Pythorian/Conversor-Buck-Didatico/README.md

# Conversor-Buck-Didatico
 Este trabalho é um conversor Buck desenvolvido para ajudar nas aulas de Eletrônica de Potência e Controle Digital.
