Pythorian/Conversor-Buck-Didatico/Referências/engenharia/IRF530.pdf

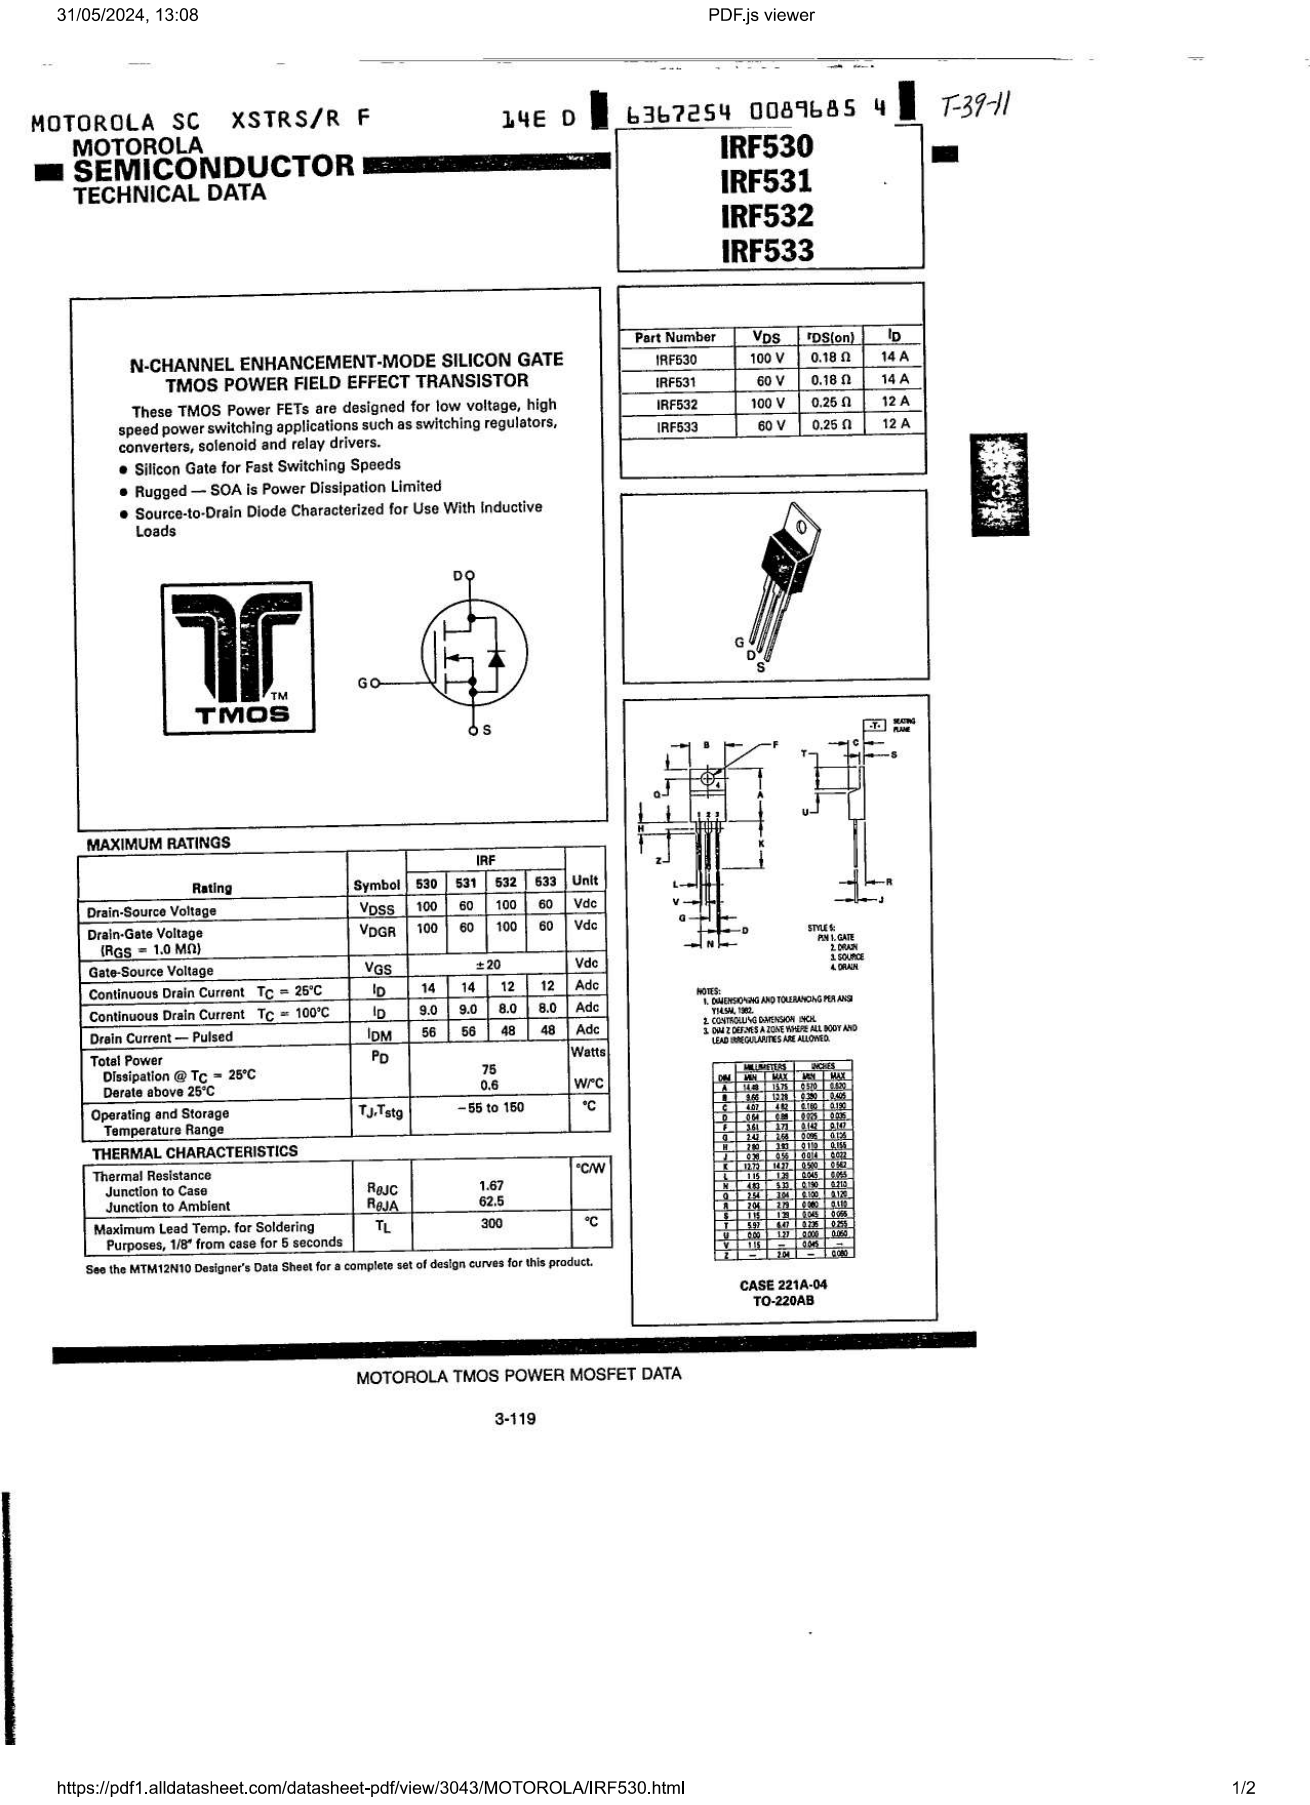
[picture p16: page 1]

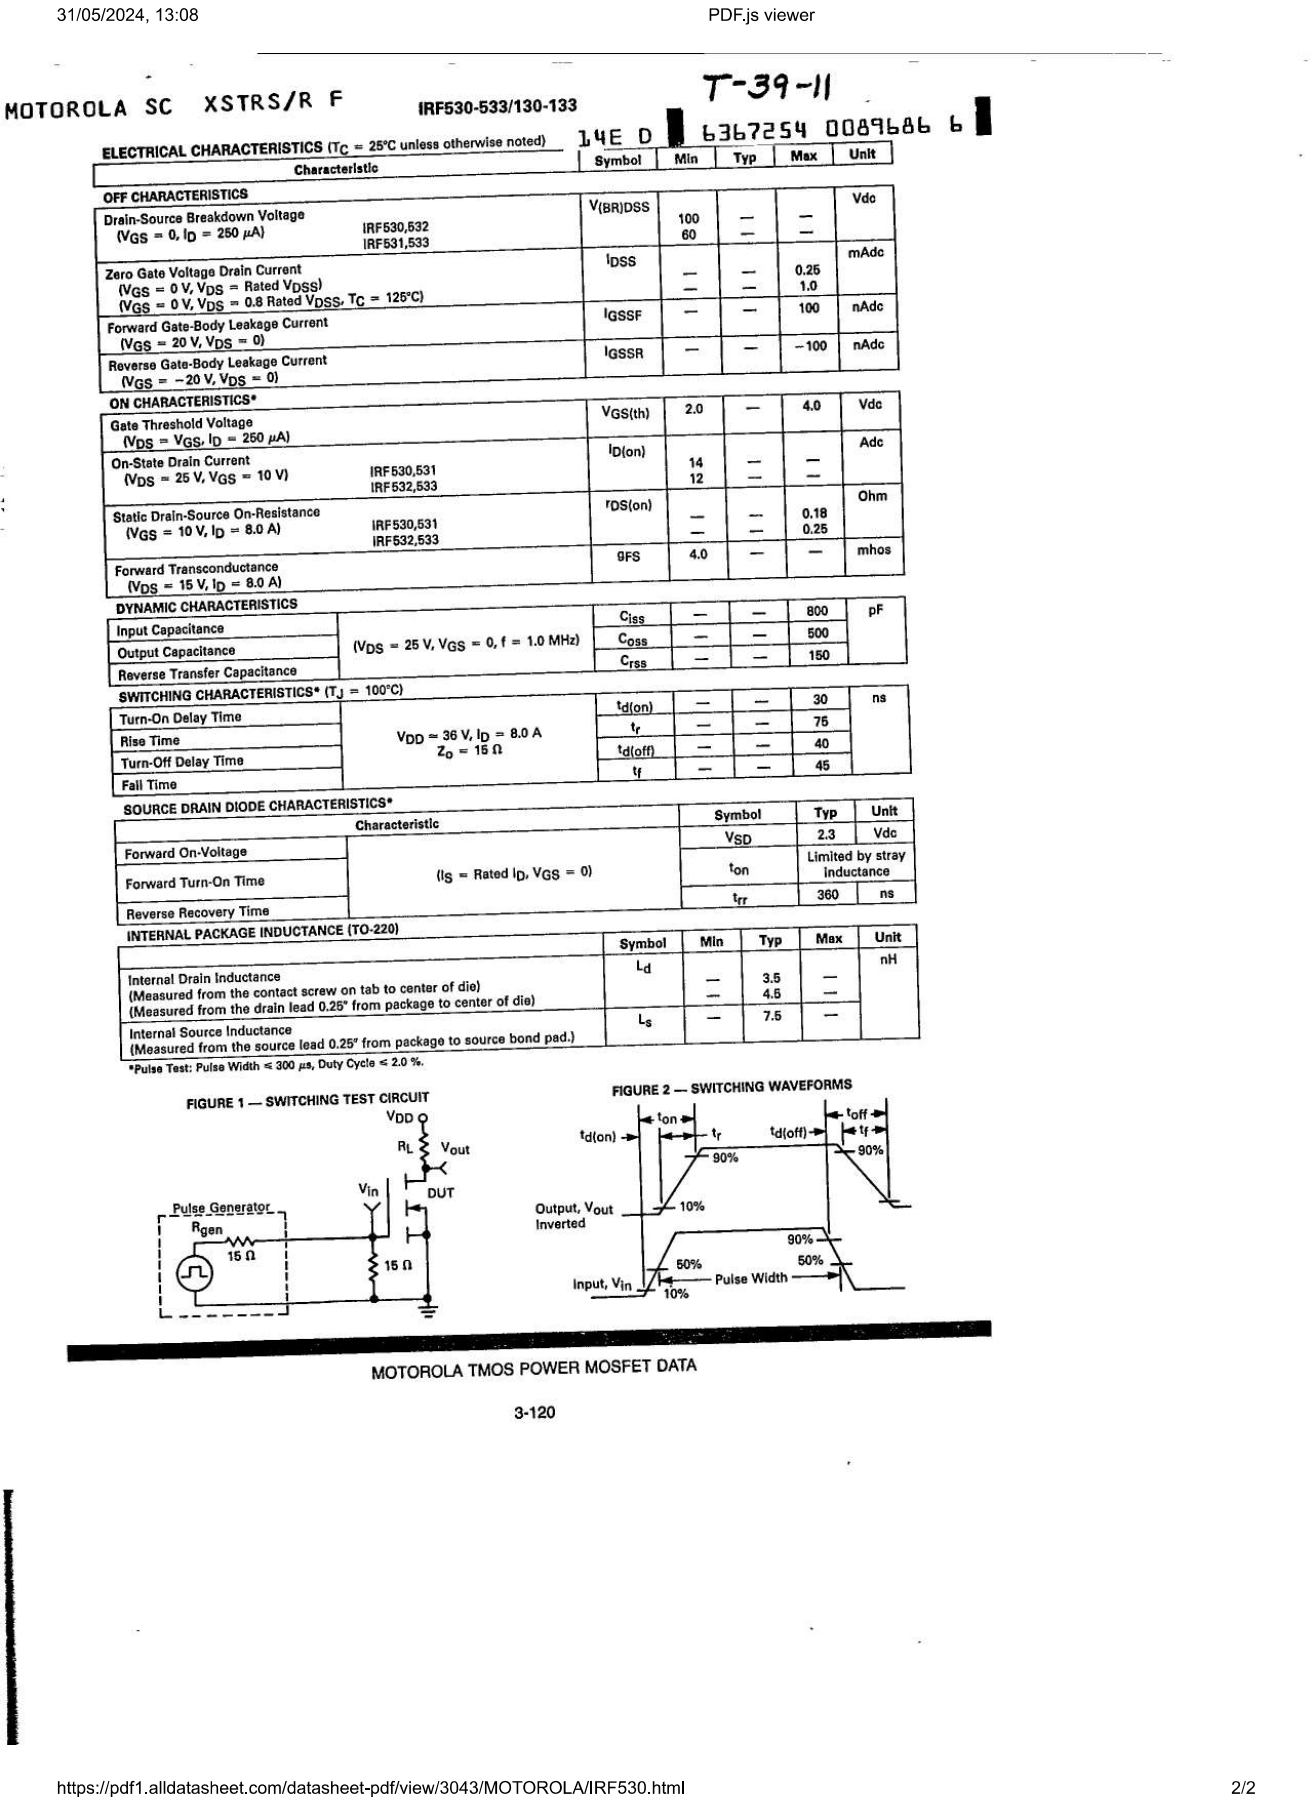
[picture p17: page 2]
