Pythorian/Conversor-Buck-Didatico/Referências/engenharia/LA25NP.pdf

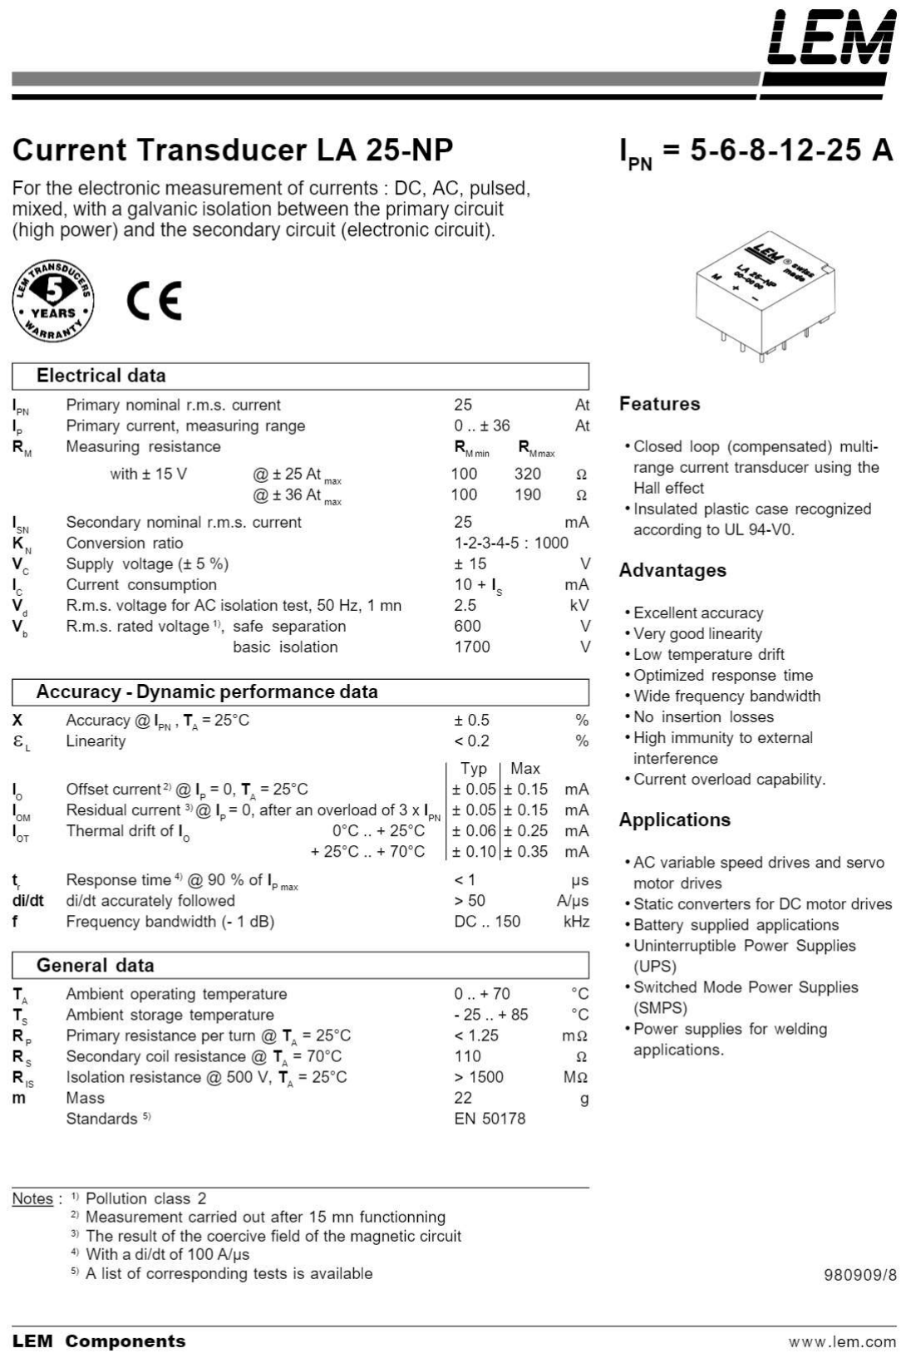
[picture p18: page 1]
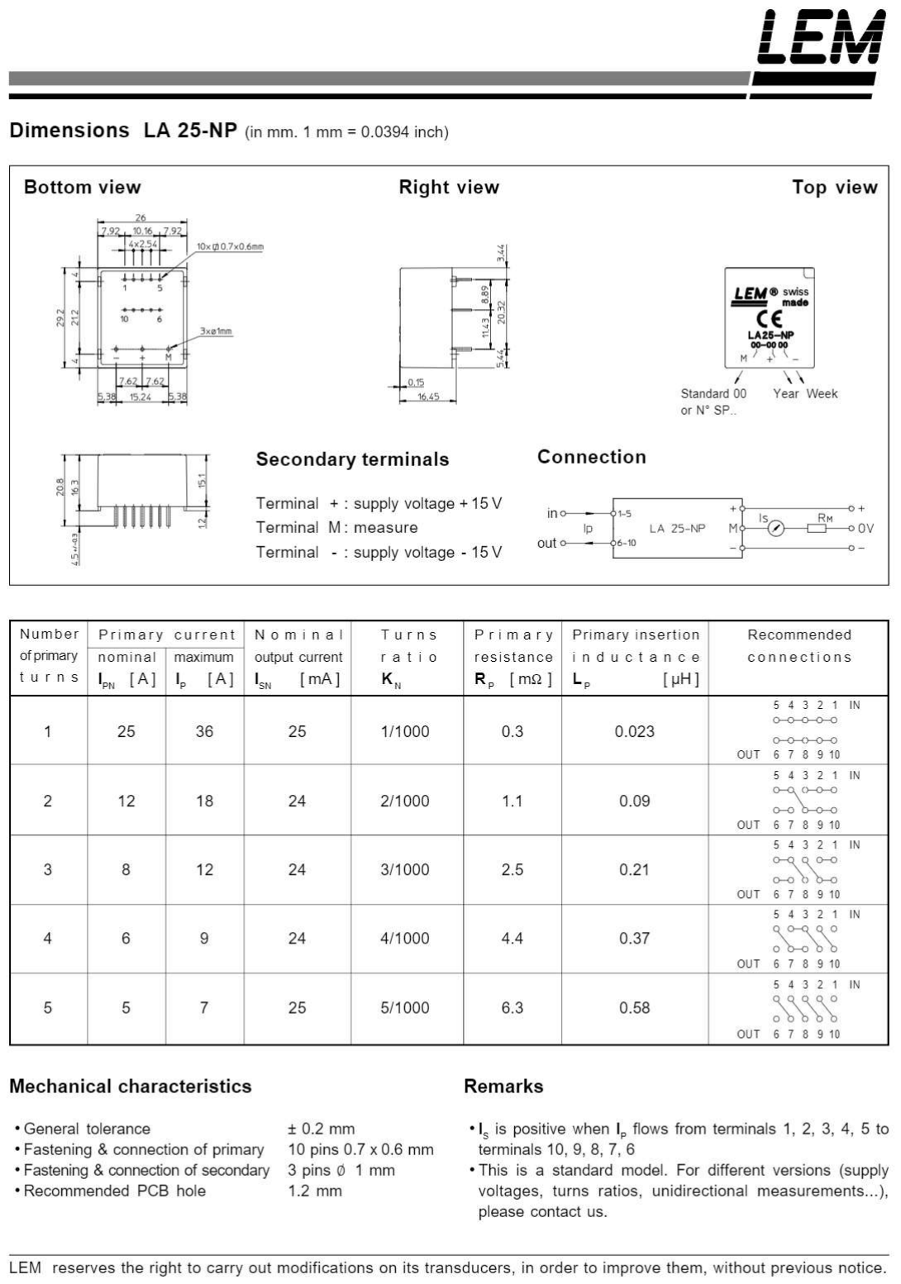
[picture p19: page 2]
