Pythorian/Conversor-Buck-Didatico/Imagens/Produzidas pelo autor/bucketapa1.png

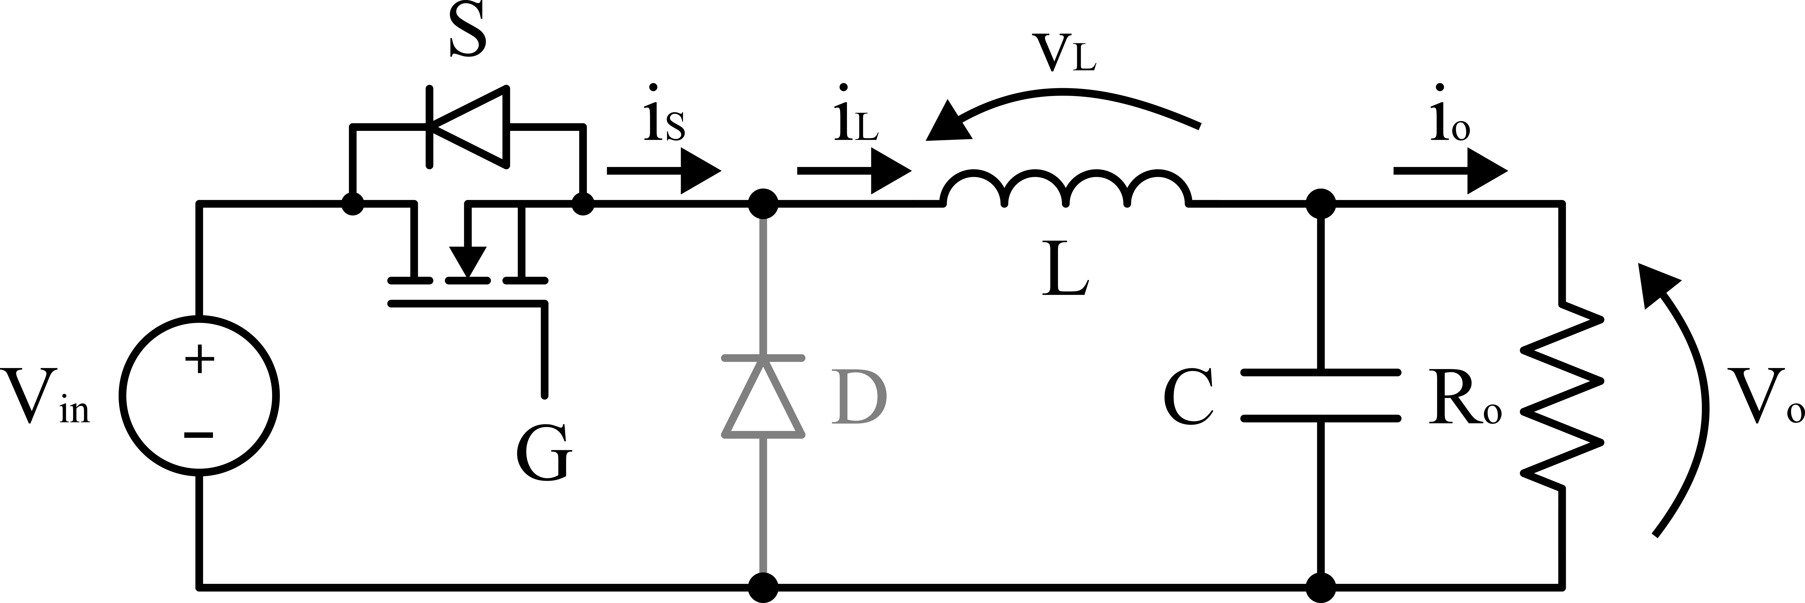
Imagens/Produzidas pelo autor/bucketapa1.png
