Pythorian/Conversor-Buck-Didatico/Imagens/Produzidas pelo autor/bucketapa1medidas.png

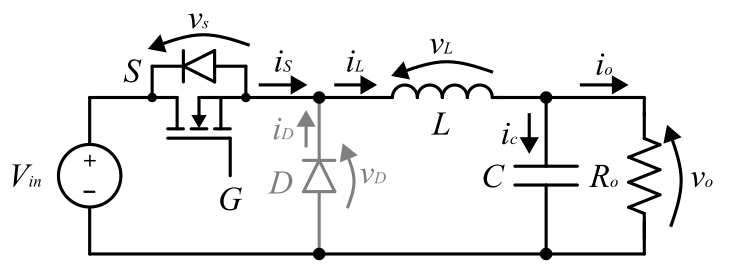
Imagens/Produzidas pelo autor/bucketapa1medidas.png
