Pythorian/Conversor-Buck-Didatico/Imagens/Produzidas pelo autor/bucketapa2.png

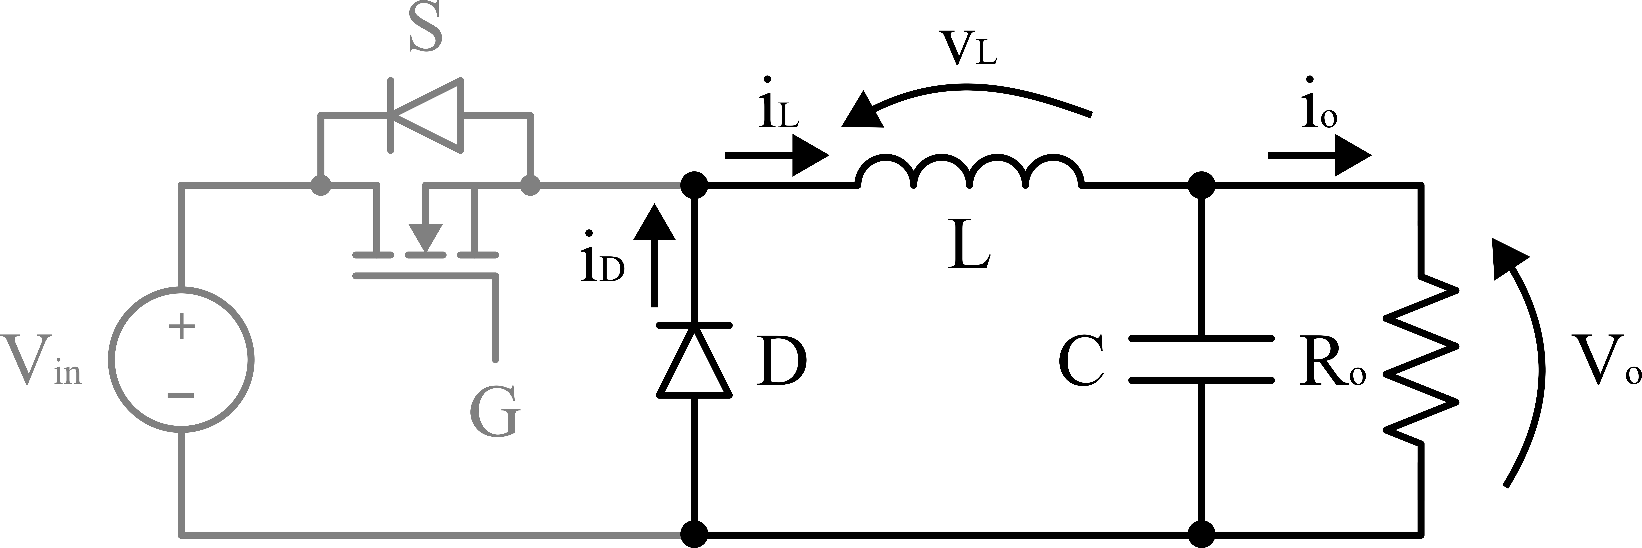
Imagens/Produzidas pelo autor/bucketapa2.png
