Pythorian/Conversor-Buck-Didatico/Imagens/Produzidas pelo autor/bucketapa2medidas.png

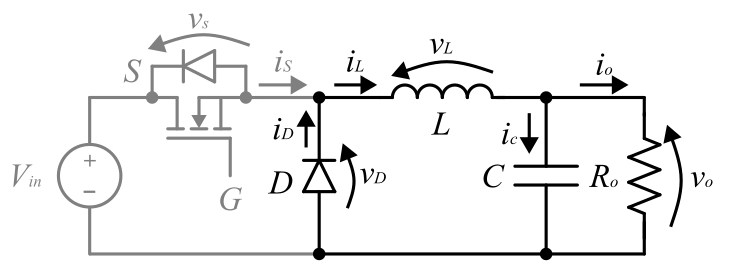
Imagens/Produzidas pelo autor/bucketapa2medidas.png
