Pythorian/Conversor-Buck-Didatico/Imagens/Produzidas pelo autor/buckgraficos.png

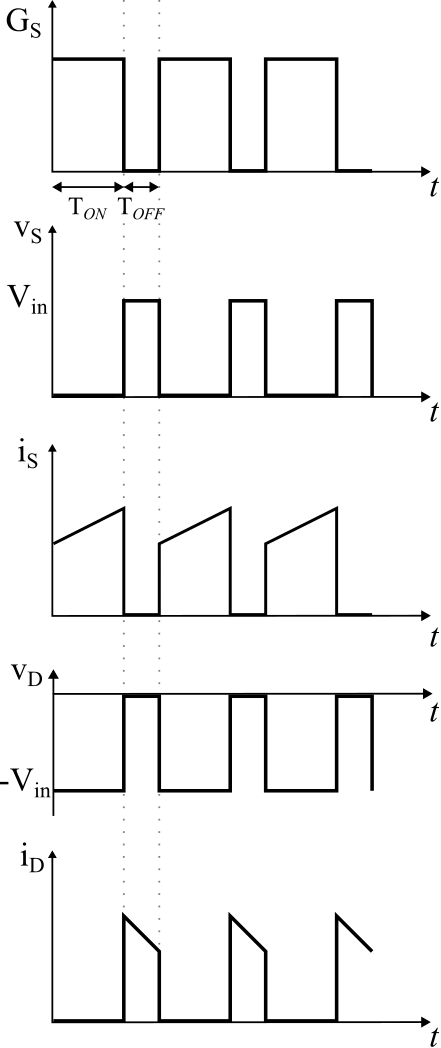
Imagens/Produzidas pelo autor/buckgraficos.png
