Pythorian/Conversor-Buck-Didatico/Imagens/Produzidas pelo autor/buckmalhatensao.png

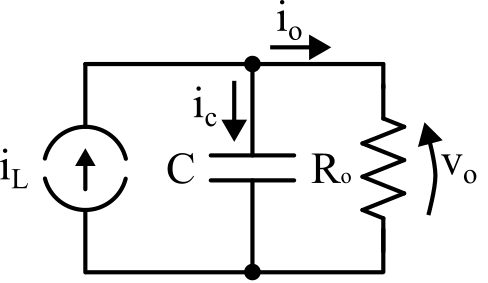
Imagens/Produzidas pelo autor/buckmalhatensao.png
