Pythorian/Conversor-Buck-Didatico/Imagens/Produzidas pelo autor/buckmedidas.png

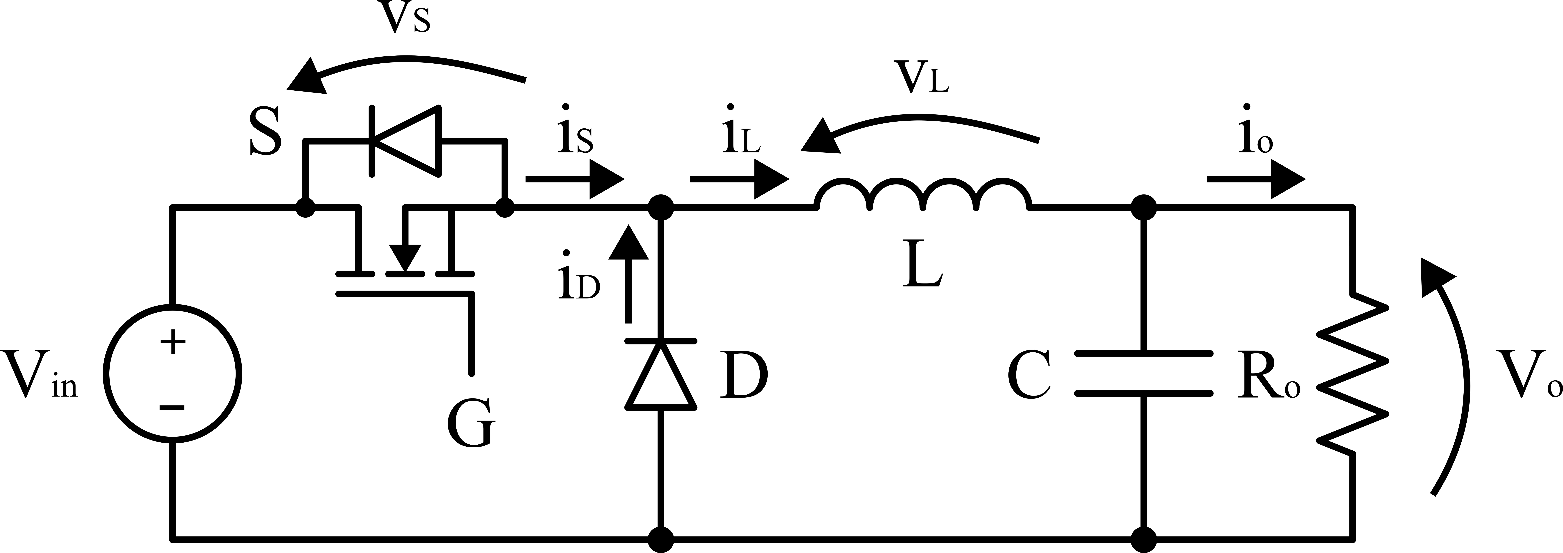
Imagens/Produzidas pelo autor/buckmedidas.png
