Pythorian/Conversor-Buck-Didatico/Imagens/Produzidas pelo autor/bucksolo.png

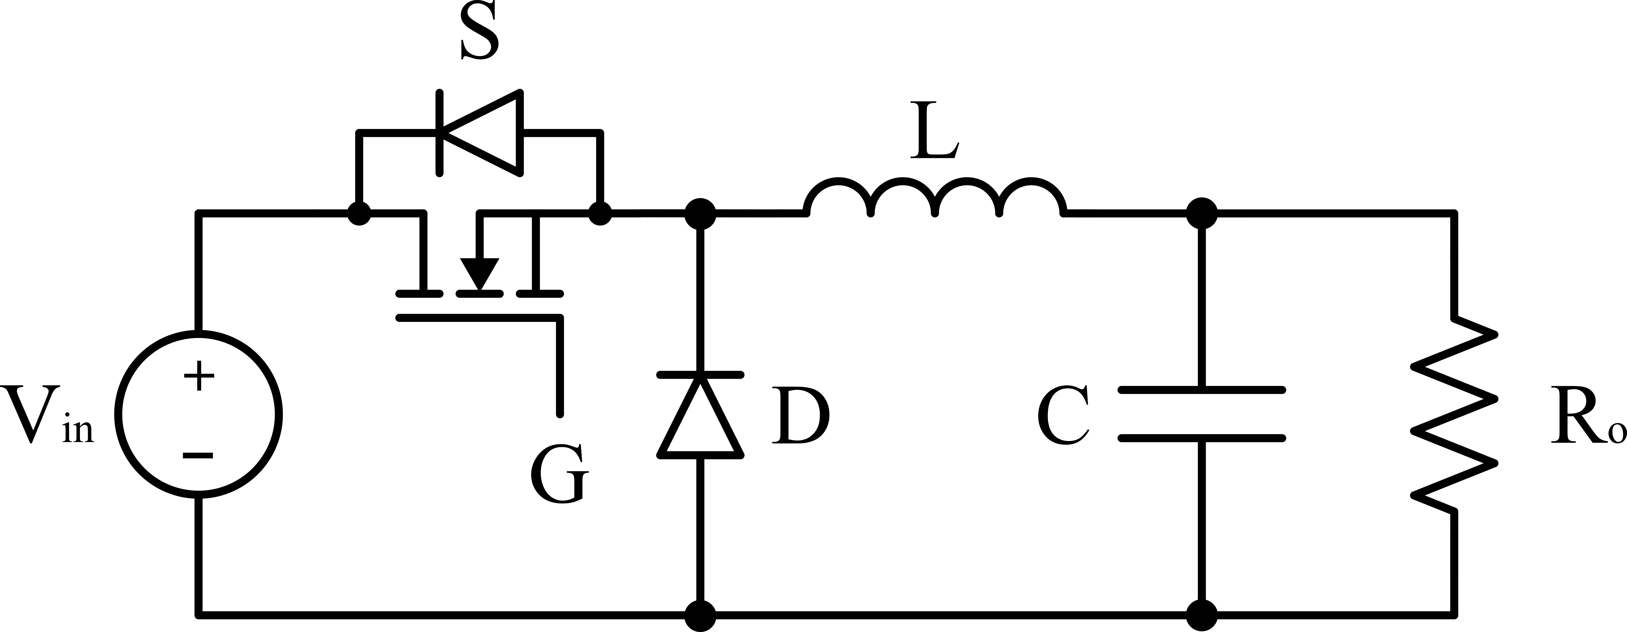
Imagens/Produzidas pelo autor/bucksolo.png
