Pythorian/Conversor-Buck-Didatico/Imagens/Produzidas pelo autor/formasdeondacapacitor.png

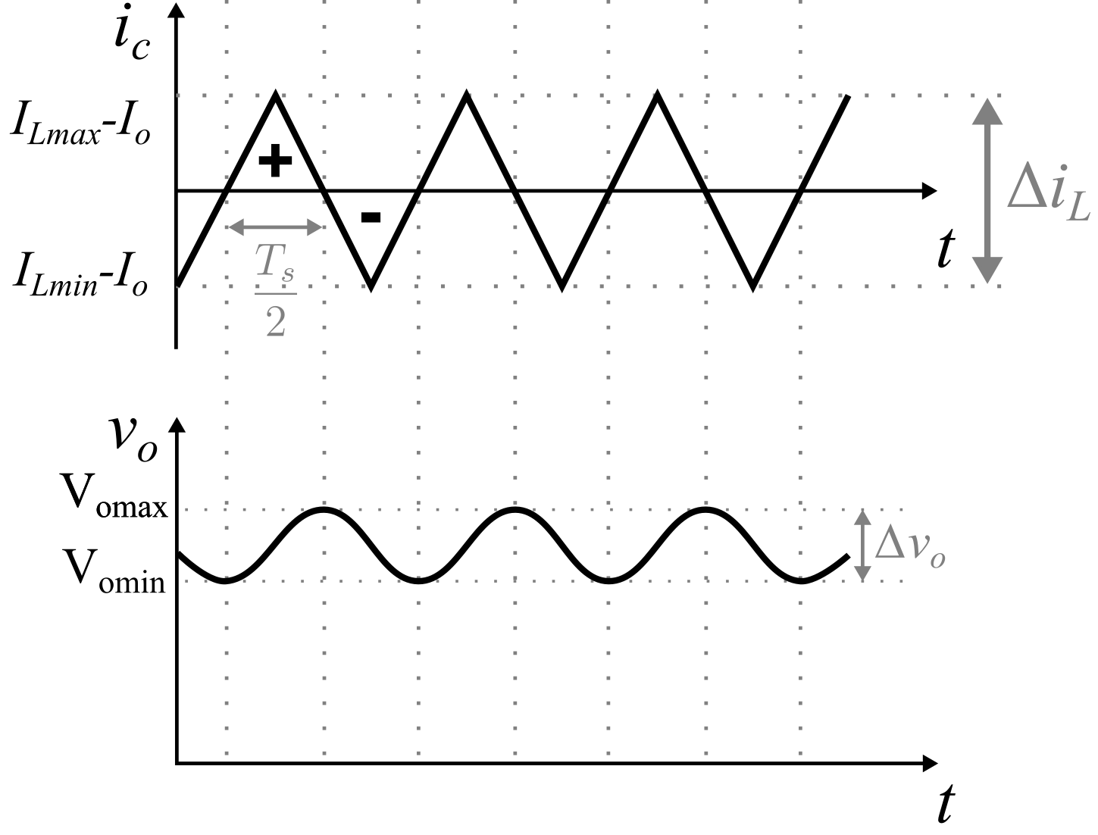
Imagens/Produzidas pelo autor/formasdeondacapacitor.png
