Pythorian/Conversor-Buck-Didatico/Imagens/Produzidas pelo autor/formasdeondaindutor.png

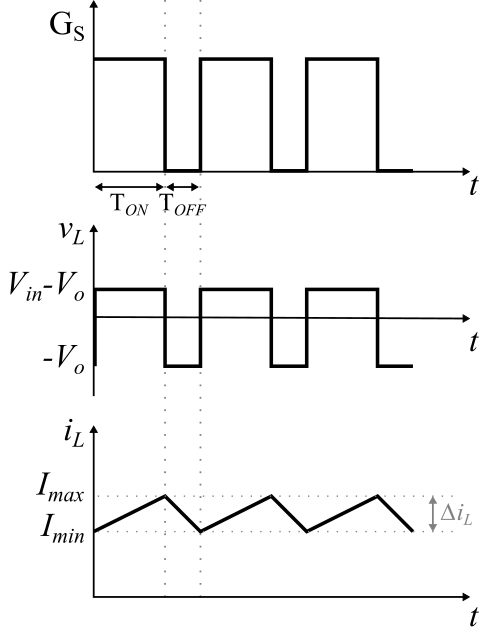
Imagens/Produzidas pelo autor/formasdeondaindutor.png
