Pythorian/Conversor-Buck-Didatico/Imagens/Produzidas pelo autor/malhascontrole.png

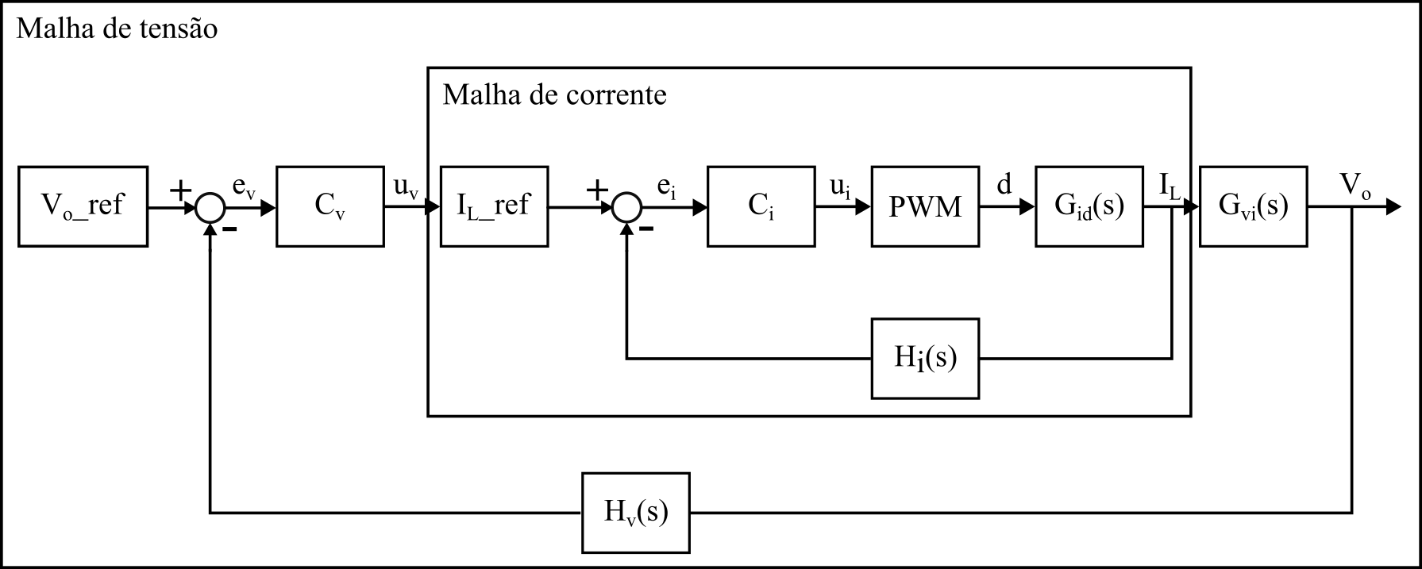
Imagens/Produzidas pelo autor/malhascontrole.png
