Pythorian/Conversor-Buck-Didatico/Imagens/Produzidas pelo autor/psimcontrolegraficos1.png

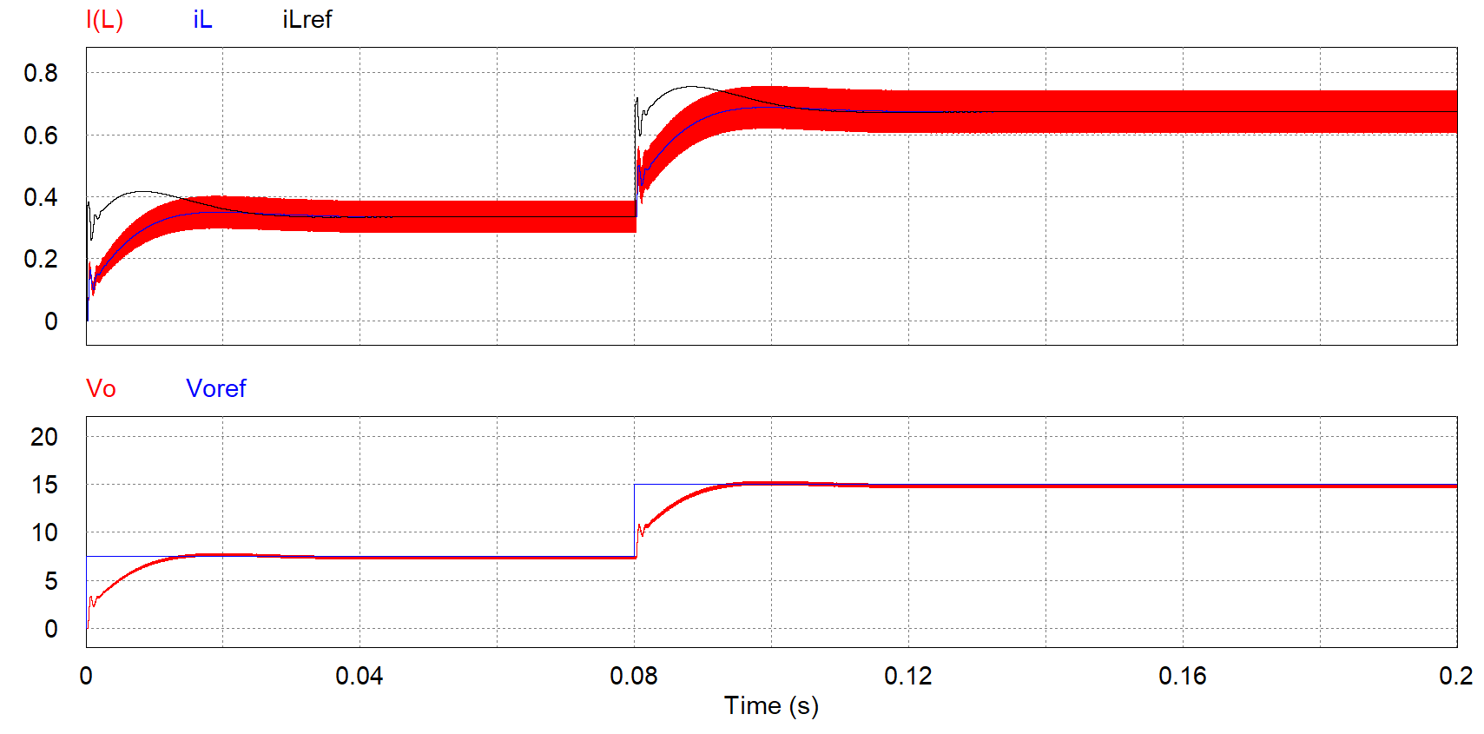
Imagens/Produzidas pelo autor/psimcontrolegraficos1.png
