Pythorian/Conversor-Buck-Didatico/Imagens/Produzidas pelo autor/psimcontrolegraficos2.png

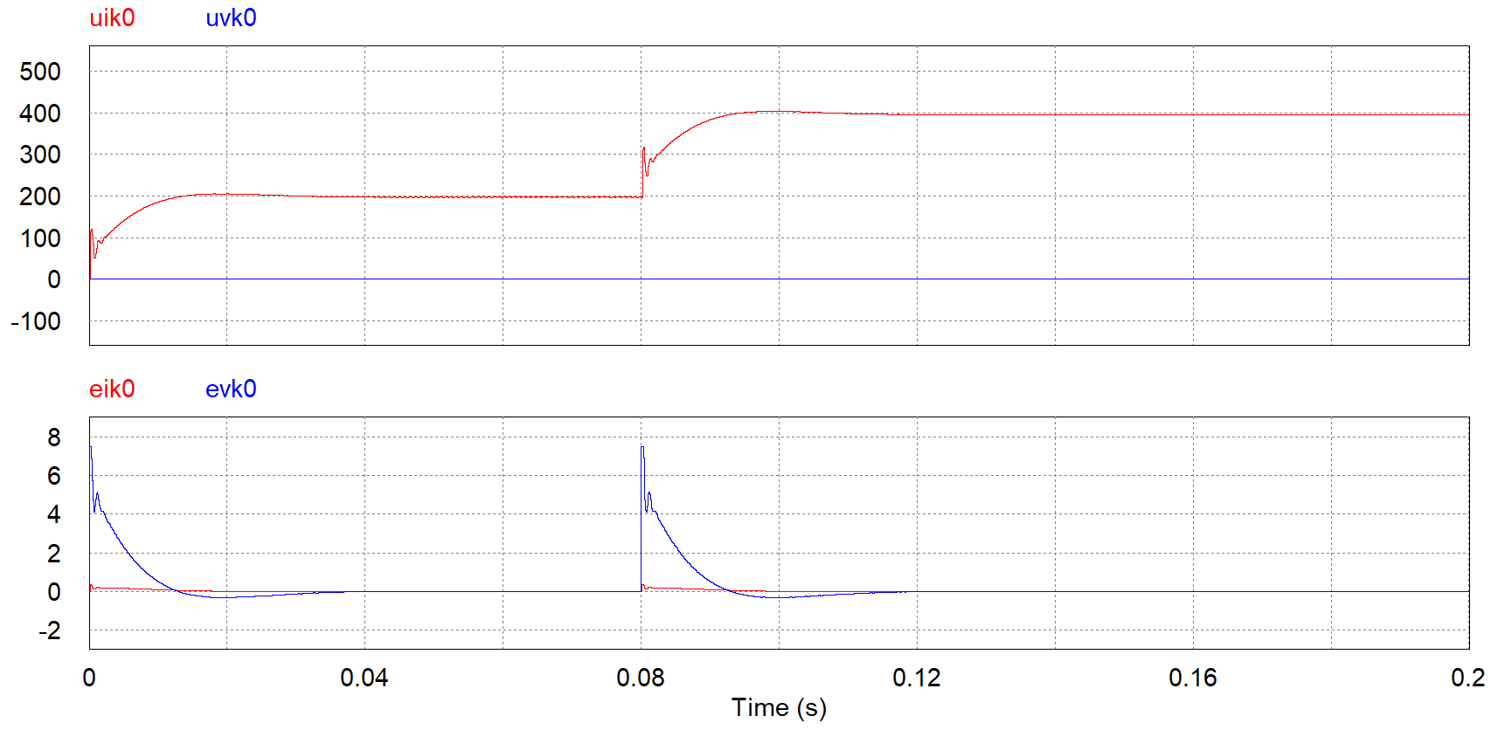
Imagens/Produzidas pelo autor/psimcontrolegraficos2.png
