Pythorian/Conversor-Buck-Didatico/Imagens/Produzidas pelo autor/psimvalidacaocorrente.png

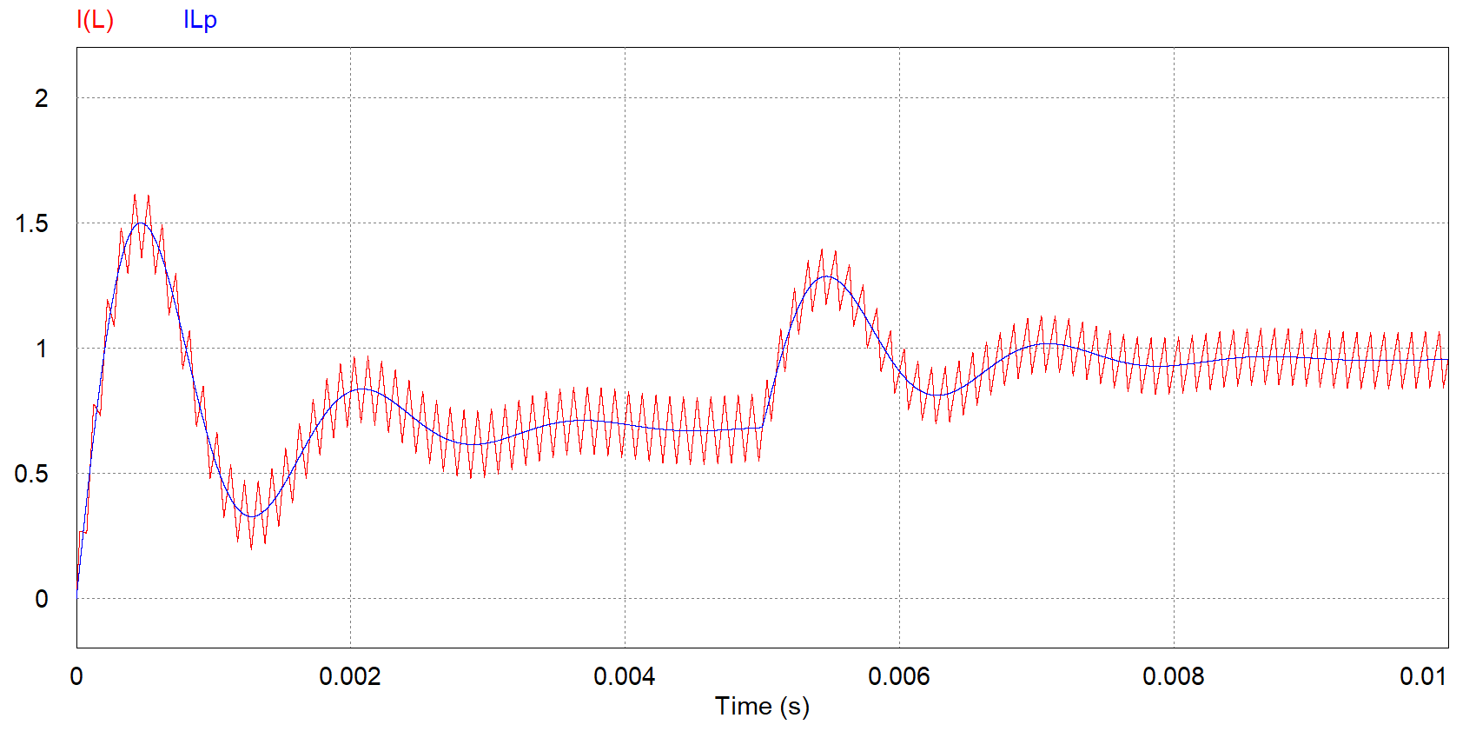
Imagens/Produzidas pelo autor/psimvalidacaocorrente.png
