Pythorian/Conversor-Buck-Didatico/Imagens/Produzidas pelo autor/psimvalidacaotensao.png

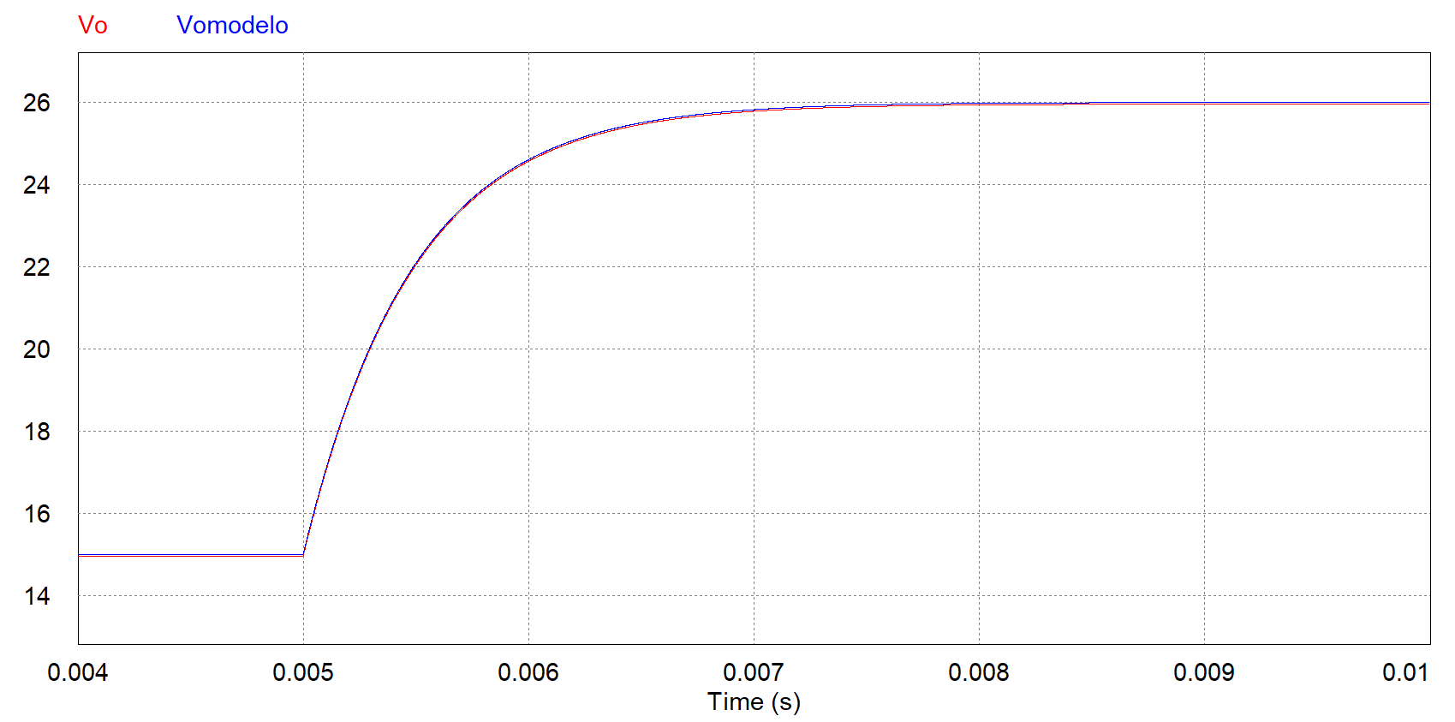
Imagens/Produzidas pelo autor/psimvalidacaotensao.png
