Pythorian/Conversor-Buck-Didatico/Imagens/Produzidas pelo autor/refcargapsim.png

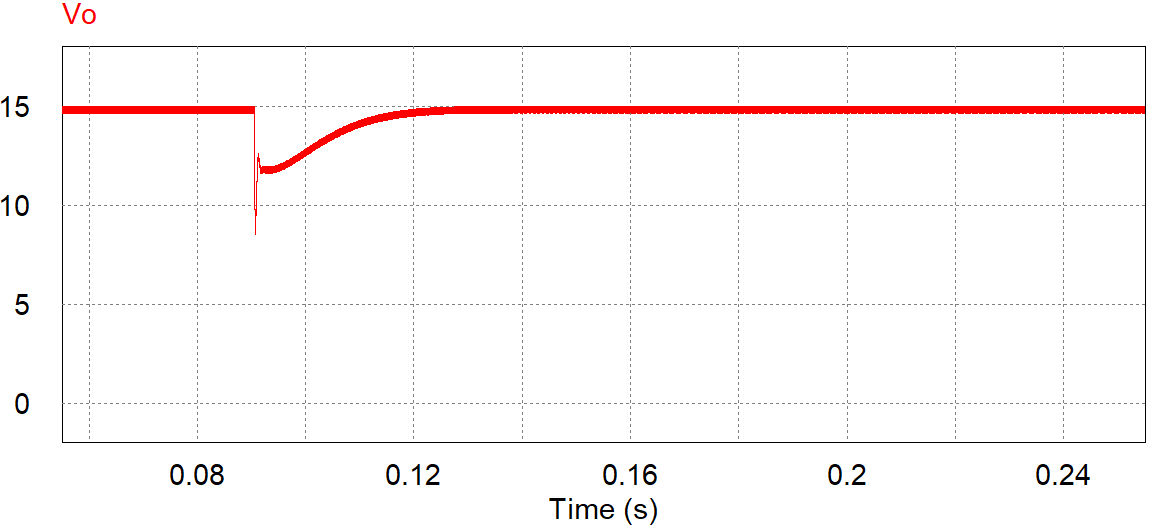
Imagens/Produzidas pelo autor/refcargapsim.png
