Pythorian/Conversor-Buck-Didatico/Imagens/Produzidas pelo autor/refcorrentepsim.png

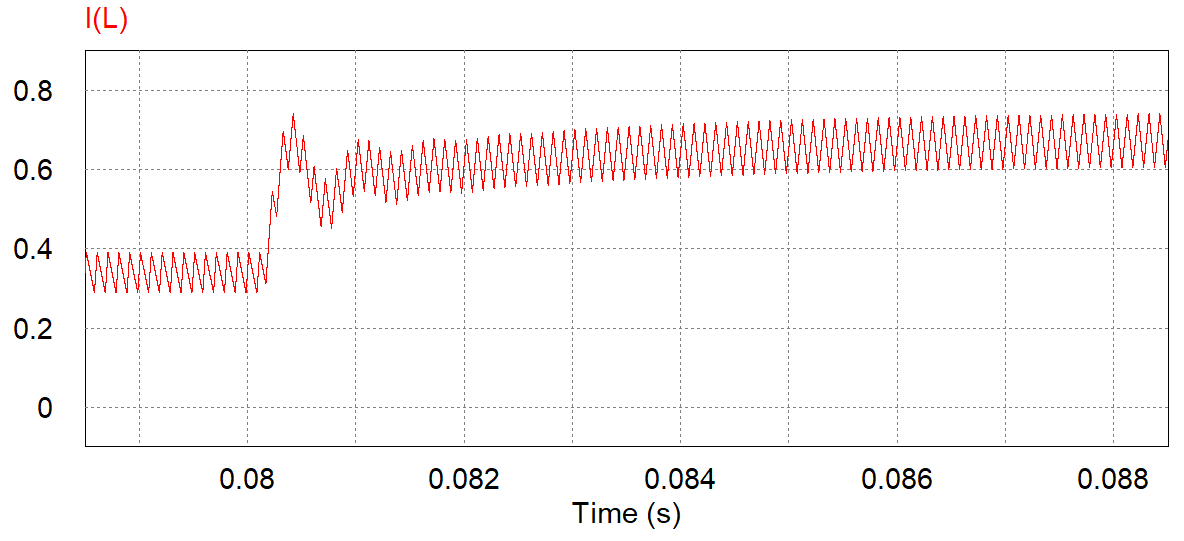
Imagens/Produzidas pelo autor/refcorrentepsim.png
