Pythorian/Conversor-Buck-Didatico/Imagens/Produzidas pelo autor/refdutycyclepsim.png

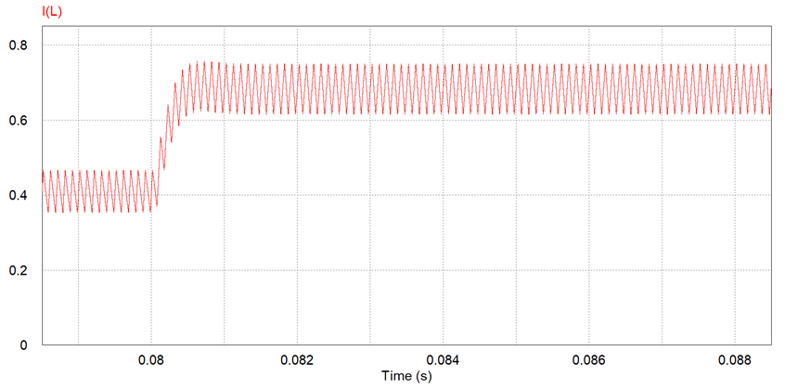
Imagens/Produzidas pelo autor/refdutycyclepsim.png
