Pythorian/Conversor-Buck-Didatico/Imagens/Produzidas pelo autor/reftensaopsim.png

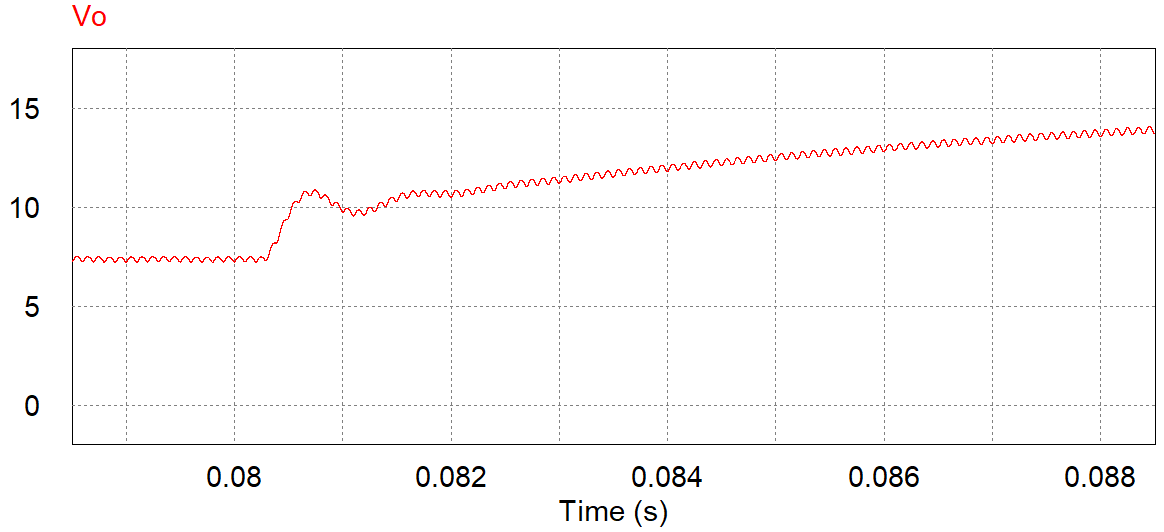
Imagens/Produzidas pelo autor/reftensaopsim.png
