Pythorian/Conversor-Buck-Didatico/Placas/GateDriver/GateDriver3d.png

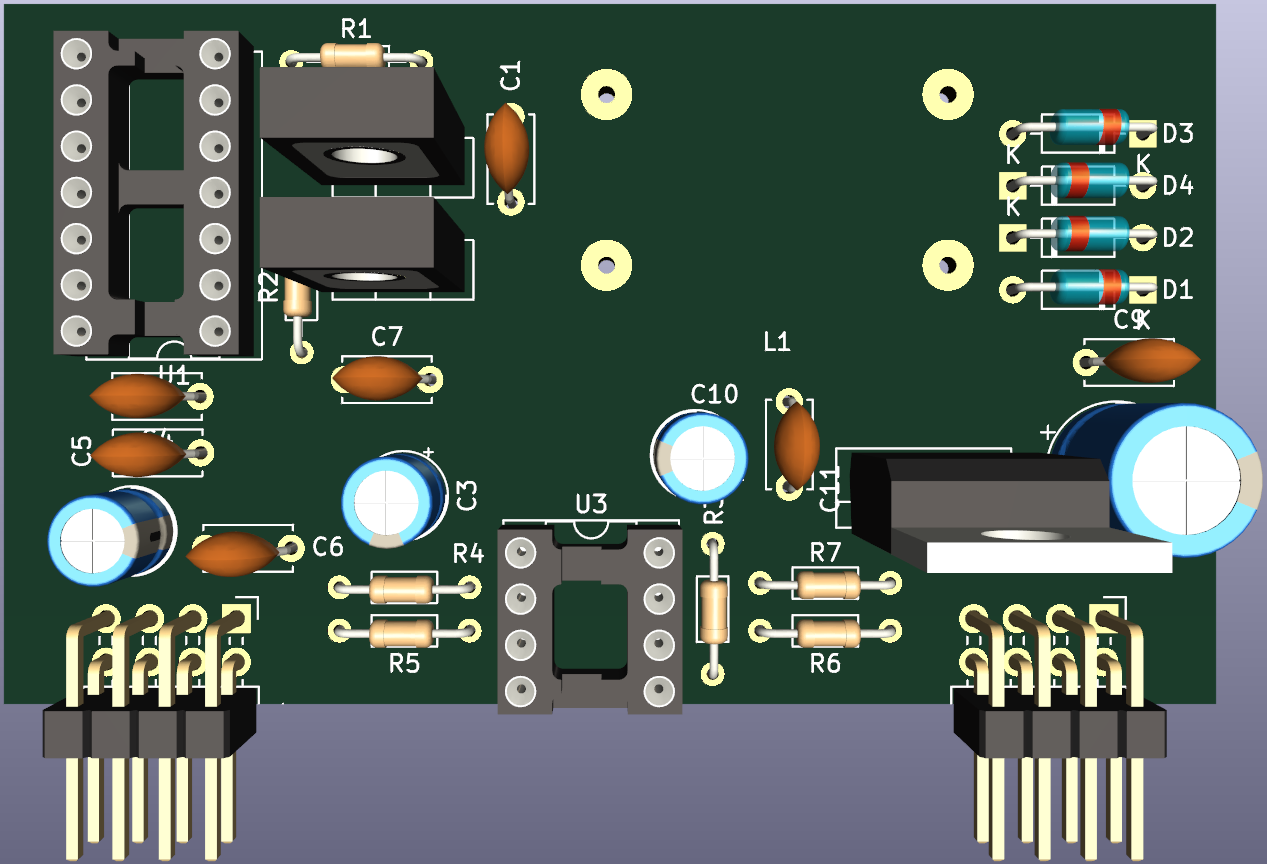
Placas/GateDriver/GateDriver3d.png
