Pythorian/Conversor-Buck-Didatico/Placas/GateDriver/gdparte1.png

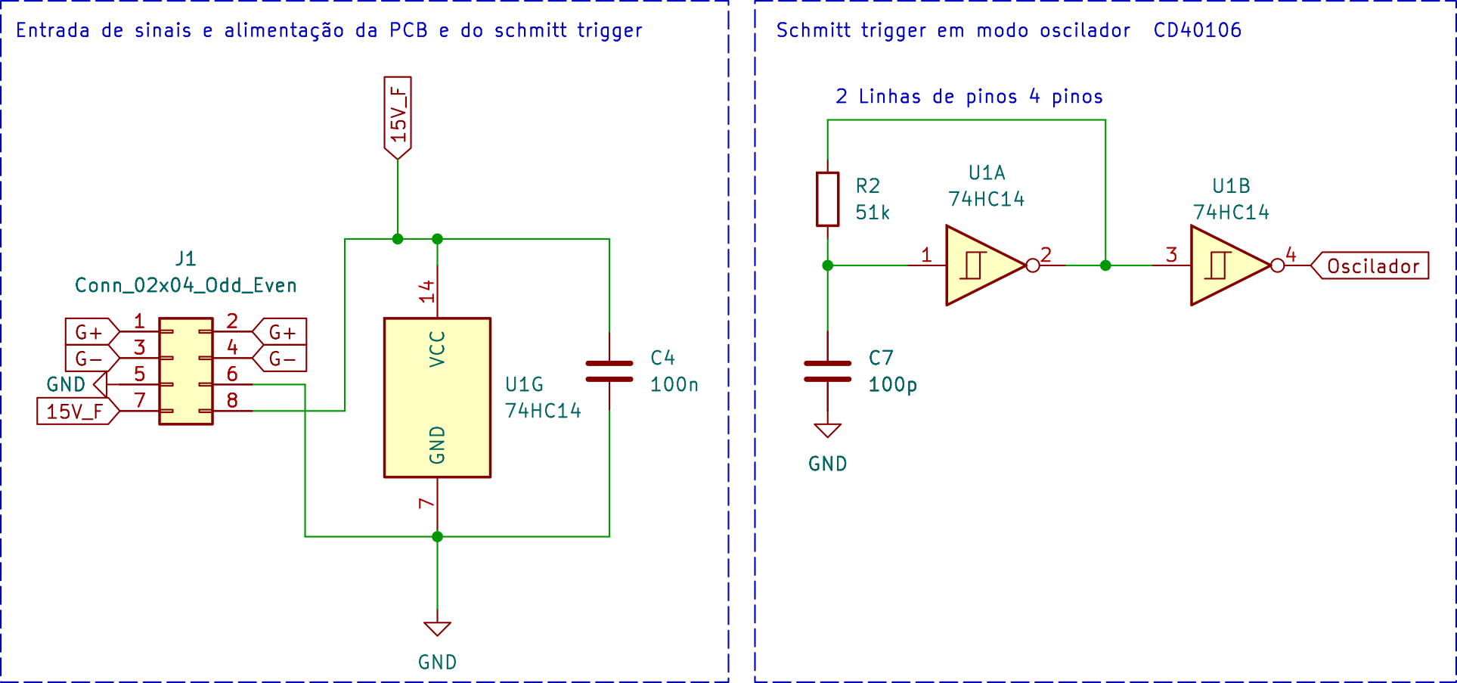
Placas/GateDriver/gdparte1.png
