Pythorian/Conversor-Buck-Didatico/Placas/GateDriver/gdparte2.png

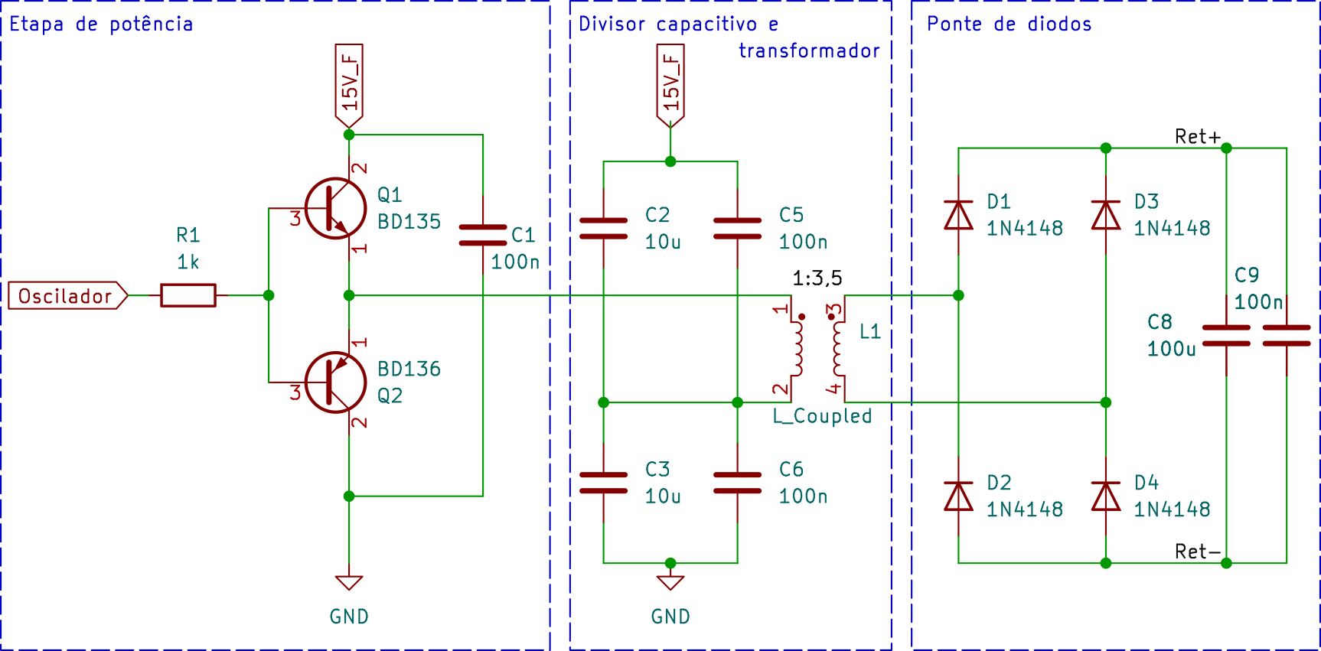
Placas/GateDriver/gdparte2.png
