Pythorian/Conversor-Buck-Didatico/Placas/GateDriver/gdparte3.png

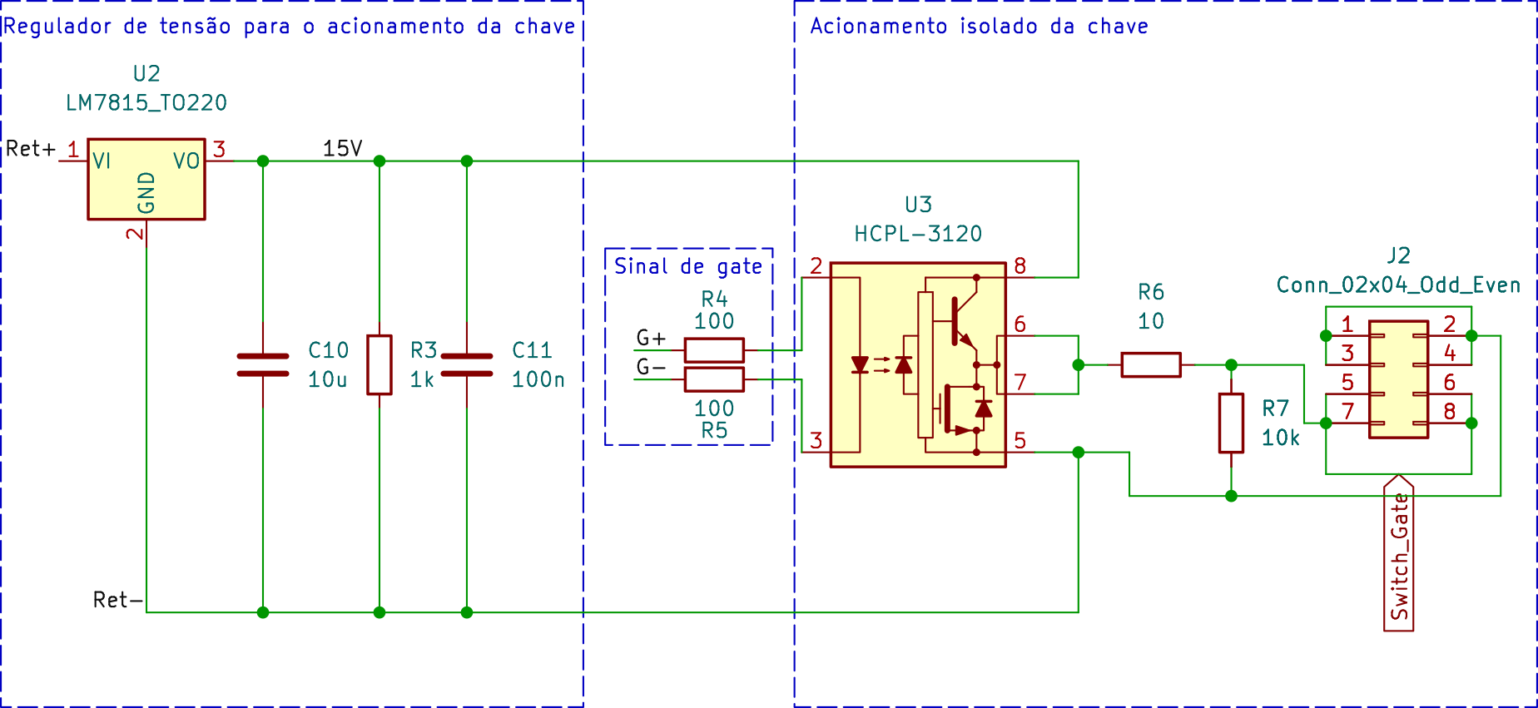
Placas/GateDriver/gdparte3.png
