Pythorian/Conversor-Buck-Didatico/Placas/Instrumentação/Instrumentação.png

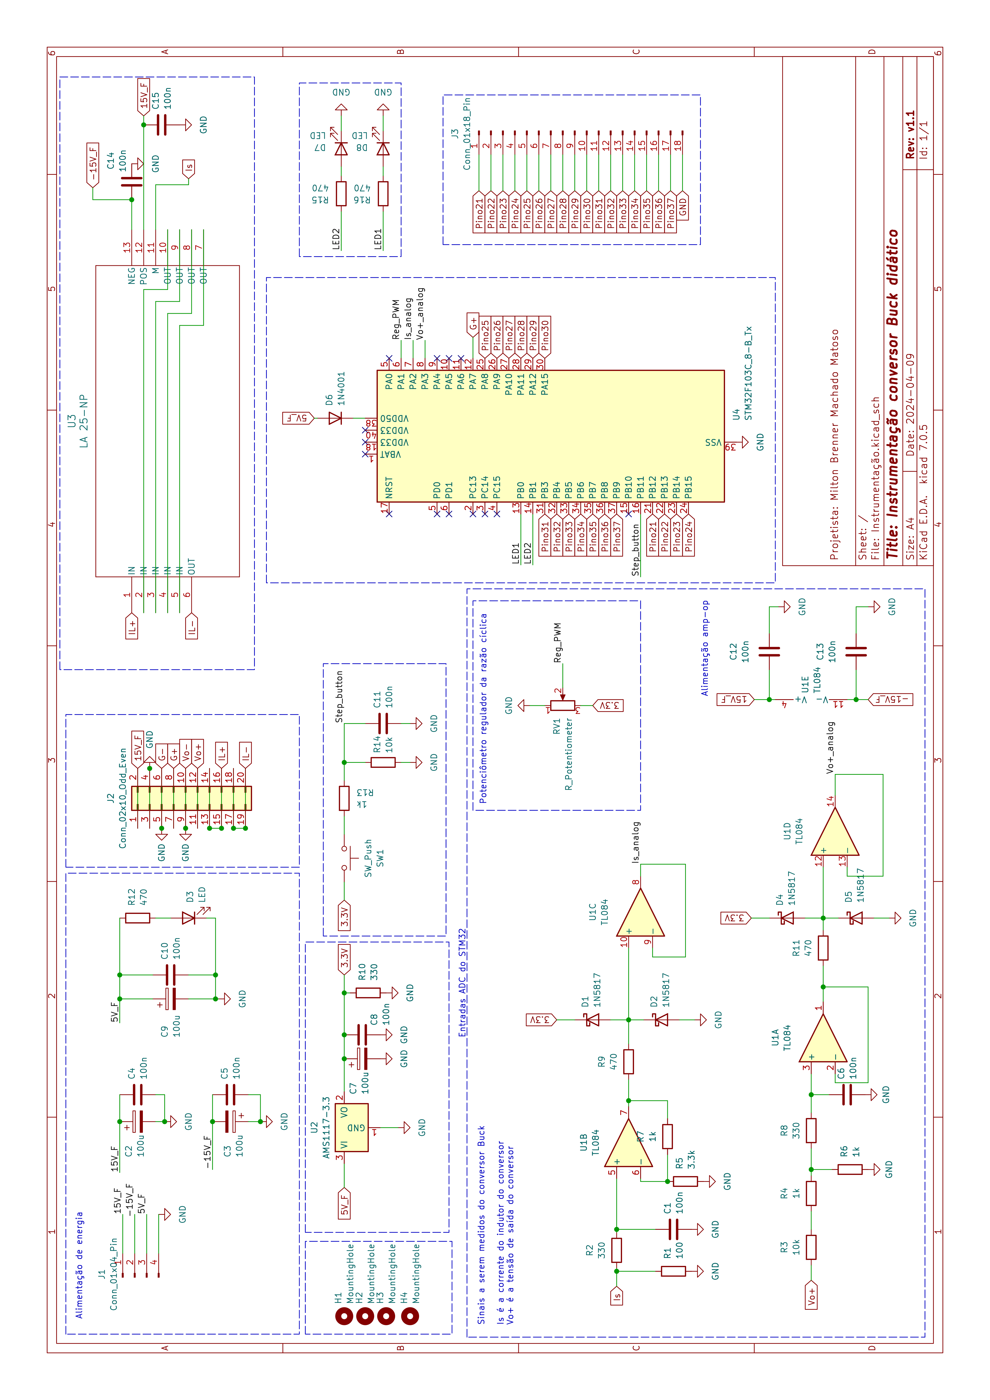
Placas/Instrumentação/Instrumentação.png
