Pythorian/Conversor-Buck-Didatico/Imagens/Experimentos/RefCarga.csv

Model | MDO4054-3
Firmware Version | 2.10
Waveform Type | ANALOG
Point Format | Y
Horizontal Units | s
Horizontal Scale | 0.02
Horizontal Delay | 0.05978
Sample Interval | 2e-05
Record Length | 10000
Gating | 0.0% to 100.0%
Probe Attenuation | 1
Vertical Units | V
Vertical Offset | 0
Vertical Scale | 2
Vertical Position | -4.02
Label
TIME | CH1
-4.0220e-02 | 15.16
-4.0200e-02 | 14.76
-4.0180e-02 | 14.76
-4.0160e-02 | 15
-4.0140e-02 | 15.32
-4.0120e-02 | 15.16
-4.0100e-02 | 14.76
-4.0080e-02 | 14.84
-4.0060e-02 | 15.16
-4.0040e-02 | 15.32
-4.0020e-02 | 15.16
-4.0000e-02 | 14.84
-3.9980e-02 | 14.84
-3.9960e-02 | 15.16
-3.9940e-02 | 15.24
-3.9920e-02 | 15.16
-3.9900e-02 | 14.84
-3.9880e-02 | 14.84
-3.9860e-02 | 15
-3.9840e-02 | 15.16
-3.9820e-02 | 15.16
-3.9800e-02 | 14.76
-3.9780e-02 | 14.76
-3.9760e-02 | 15.08
-3.9740e-02 | 15.24
-3.9720e-02 | 15.16
-3.9700e-02 | 14.76
-3.9680e-02 | 14.76
-3.9660e-02 | 15.08
-3.9640e-02 | 15.32
-3.9620e-02 | 15.16
-3.9600e-02 | 14.76
-3.9580e-02 | 14.84
-3.9560e-02 | 15
-3.9540e-02 | 15.24
-3.9520e-02 | 15.08
-3.9500e-02 | 14.84
-3.9480e-02 | 14.84
-3.9460e-02 | 15.08
-3.9440e-02 | 15.24
-3.9420e-02 | 15
-3.9400e-02 | 14.84
-3.9380e-02 | 14.84
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
