Pythorian/Conversor-Buck-Didatico/Imagens/Experimentos/RefDutyCycle.csv

Model | MDO4054-3
Firmware Version | 2.10
Waveform Type | ANALOG
Point Format | Y
Horizontal Units | s
Horizontal Scale | 0.001
Horizontal Delay | 0.00296
Sample Interval | 1e-06
Record Length | 10000
Gating | 0.0% to 100.0%
Probe Attenuation | 10
Vertical Units | A
Vertical Offset | 0
Vertical Scale | 0.1
Vertical Position | -4.04
Label
TIME | CH2
-2.0400e-03 | 0.384
-2.0390e-03 | 0.36
-2.0380e-03 | 0.364
-2.0370e-03 | 0.344
-2.0360e-03 | 0.352
-2.0350e-03 | 0.372
-2.0340e-03 | 0.368
-2.0330e-03 | 0.372
-2.0320e-03 | 0.388
-2.0310e-03 | 0.364
-2.0300e-03 | 0.364
-2.0290e-03 | 0.372
-2.0280e-03 | 0.376
-2.0270e-03 | 0.384
-2.0260e-03 | 0.36
-2.0250e-03 | 0.352
-2.0240e-03 | 0.348
-2.0230e-03 | 0.352
-2.0220e-03 | 0.368
-2.0210e-03 | 0.376
-2.0200e-03 | 0.368
-2.0190e-03 | 0.364
-2.0180e-03 | 0.364
-2.0170e-03 | 0.364
-2.0160e-03 | 0.372
-2.0150e-03 | 0.372
-2.0140e-03 | 0.388
-2.0130e-03 | 0.38
-2.0120e-03 | 0.384
-2.0110e-03 | 0.392
-2.0100e-03 | 0.388
-2.0090e-03 | 0.384
-2.0080e-03 | 0.38
-2.0070e-03 | 0.384
-2.0060e-03 | 0.376
-2.0050e-03 | 0.376
-2.0040e-03 | 0.356
-2.0030e-03 | 0.352
-2.0020e-03 | 0.348
-2.0010e-03 | 0.36
-2.0000e-03 | 0.36
-1.9990e-03 | 0.372
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
