Pythorian/Conversor-Buck-Didatico/Imagens/Experimentos/RefTensao.csv

Model | MDO4054-3
Firmware Version | 2.10
Waveform Type | ANALOG
Point Format | Y
Horizontal Units | s
Horizontal Scale | 0.001
Horizontal Delay | 0.002993
Sample Interval | 1e-06
Record Length | 10000
Gating | 0.0% to 100.0%
Probe Attenuation | 1
Vertical Units | V
Vertical Offset | 0
Vertical Scale | 2
Vertical Position | -4.02
Label
TIME | CH1
-2.0070e-03 | 7.88
-2.0060e-03 | 7.88
-2.0050e-03 | 7.96
-2.0040e-03 | 7.88
-2.0030e-03 | 7.96
-2.0020e-03 | 7.88
-2.0010e-03 | 7.88
-2.0000e-03 | 7.88
-1.9990e-03 | 7.88
-1.9980e-03 | 7.96
-1.9970e-03 | 7.8
-1.9960e-03 | 7.88
-1.9950e-03 | 7.8
-1.9940e-03 | 7.88
-1.9930e-03 | 7.88
-1.9920e-03 | 7.8
-1.9910e-03 | 7.8
-1.9900e-03 | 7.8
-1.9890e-03 | 7.8
-1.9880e-03 | 7.8
-1.9870e-03 | 7.8
-1.9860e-03 | 7.8
-1.9850e-03 | 7.88
-1.9840e-03 | 7.88
-1.9830e-03 | 7.72
-1.9820e-03 | 7.72
-1.9810e-03 | 7.72
-1.9800e-03 | 7.64
-1.9790e-03 | 7.72
-1.9780e-03 | 7.64
-1.9770e-03 | 7.64
-1.9760e-03 | 7.64
-1.9750e-03 | 7.72
-1.9740e-03 | 7.64
-1.9730e-03 | 7.72
-1.9720e-03 | 7.64
-1.9710e-03 | 7.56
-1.9700e-03 | 7.72
-1.9690e-03 | 7.72
-1.9680e-03 | 7.64
-1.9670e-03 | 7.56
-1.9660e-03 | 7.64
-1.9650e-03 | 7.64
-1.9640e-03 | 7.64
-1.9630e-03 | 7.56
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
