Pythorian/Conversor-Buck-Didatico/Imagens/Experimentos/Chave.png

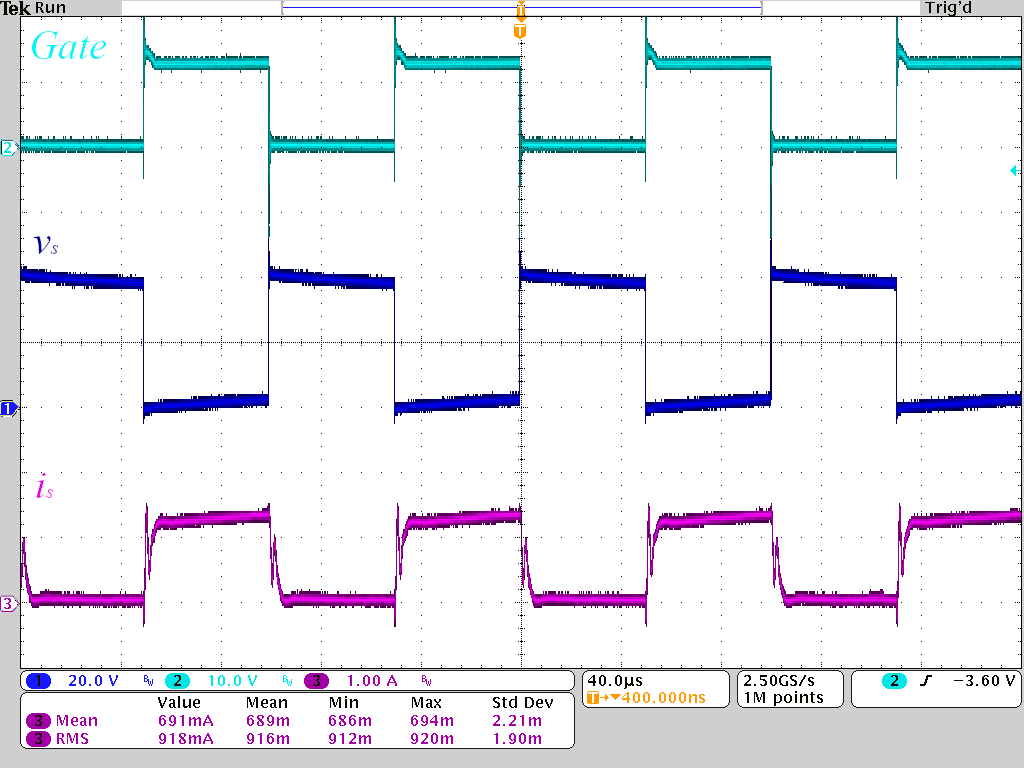
Imagens/Experimentos/Chave.png
