Pythorian/Conversor-Buck-Didatico/Imagens/Experimentos/Diodo.png

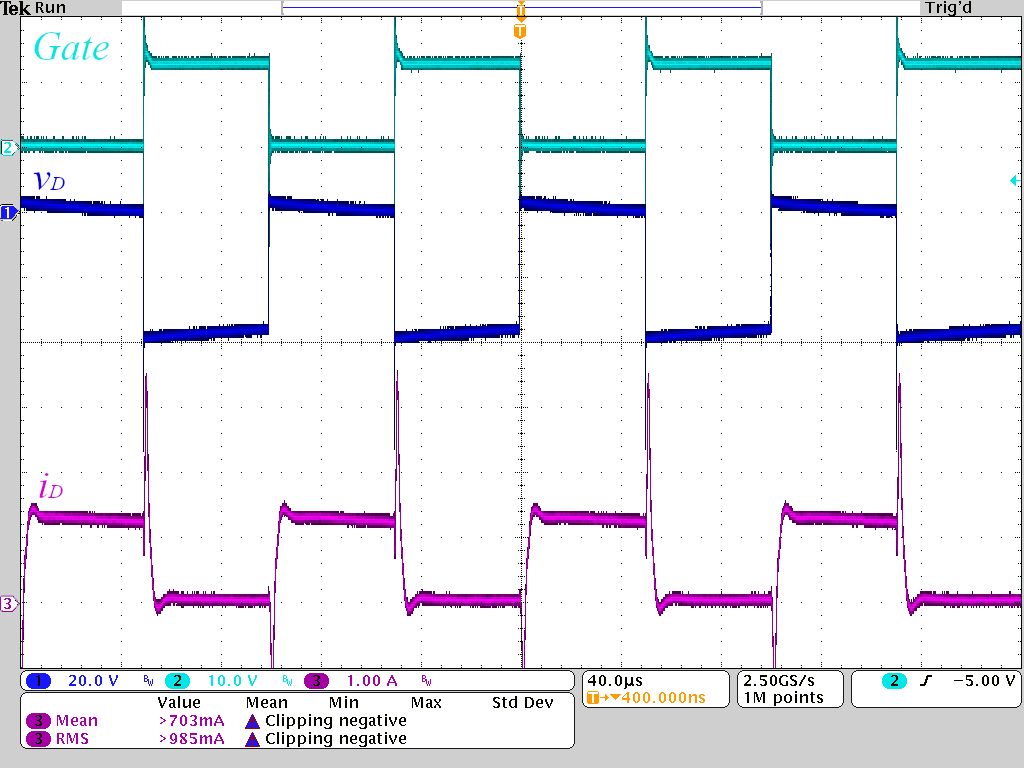
Imagens/Experimentos/Diodo.png
