Pythorian/Conversor-Buck-Didatico/Imagens/Experimentos/iLdeltaL1.png

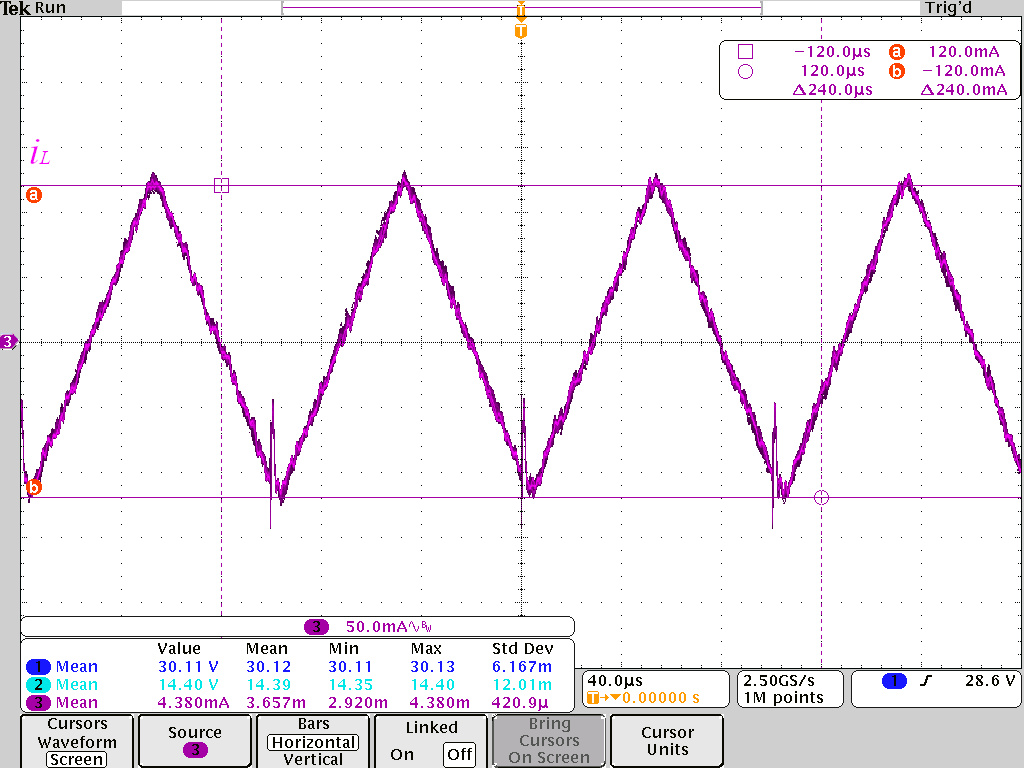
Imagens/Experimentos/iLdeltaL1.png
