Pythorian/Conversor-Buck-Didatico/Imagens/Experimentos/iLdeltaL2.png

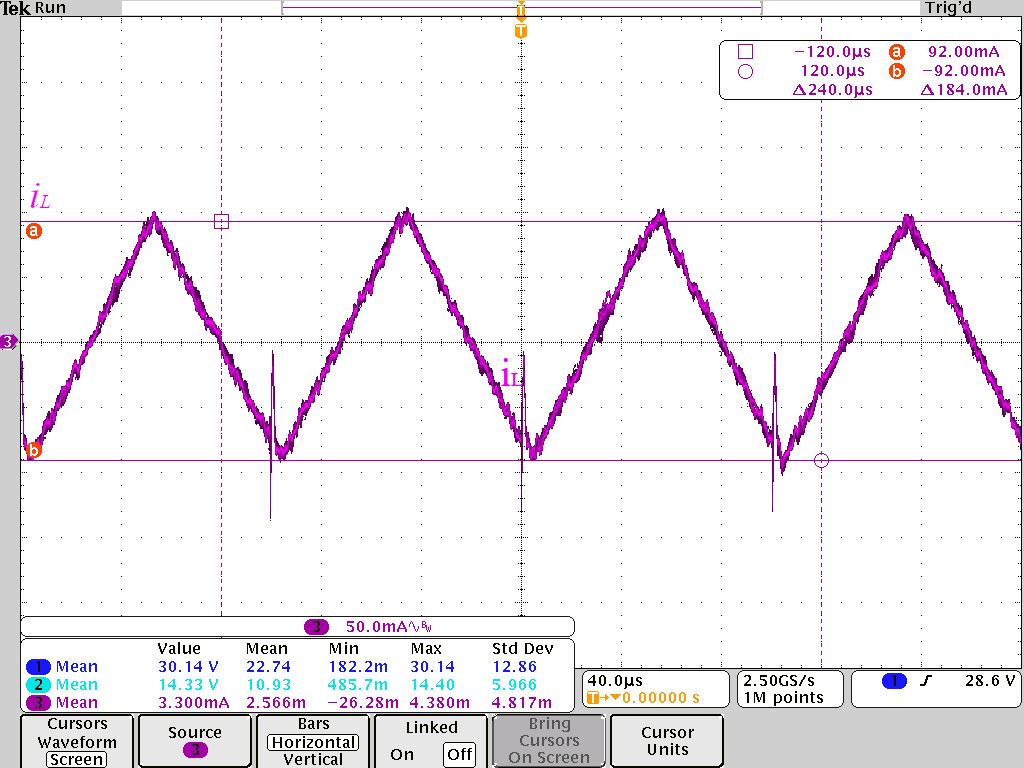
Imagens/Experimentos/iLdeltaL2.png
