Pythorian/Conversor-Buck-Didatico/Imagens/Experimentos/iLdeltaL3.png

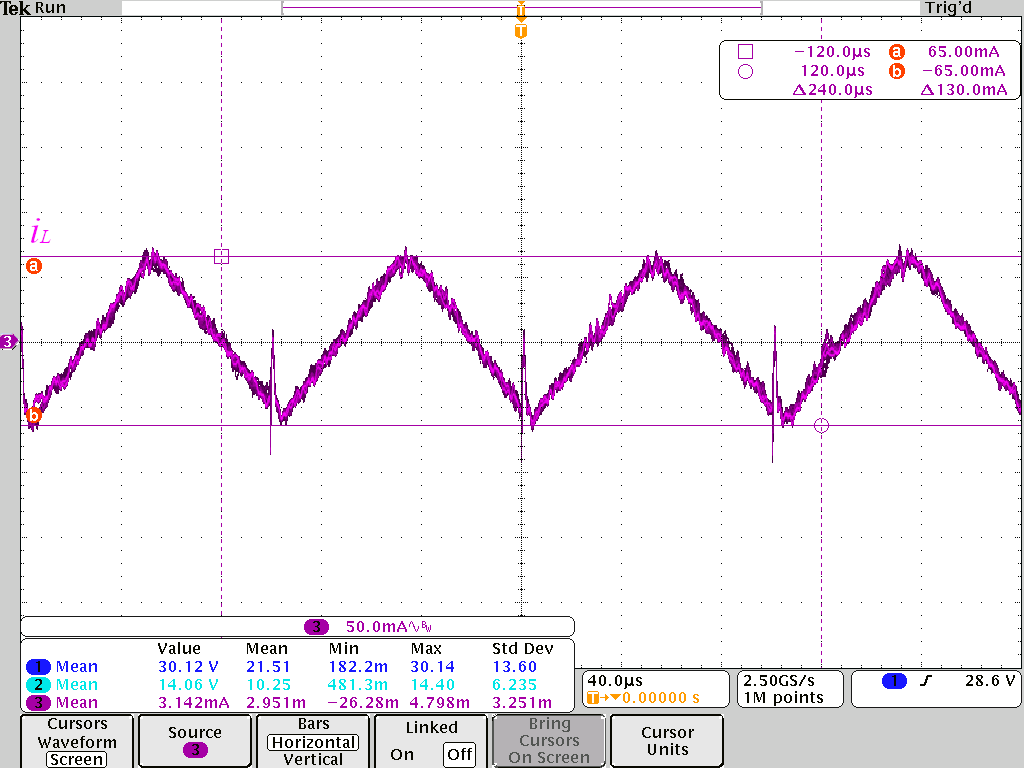
Imagens/Experimentos/iLdeltaL3.png
