Pythorian/Conversor-Buck-Didatico/Imagens/Experimentos/iLmedio.png

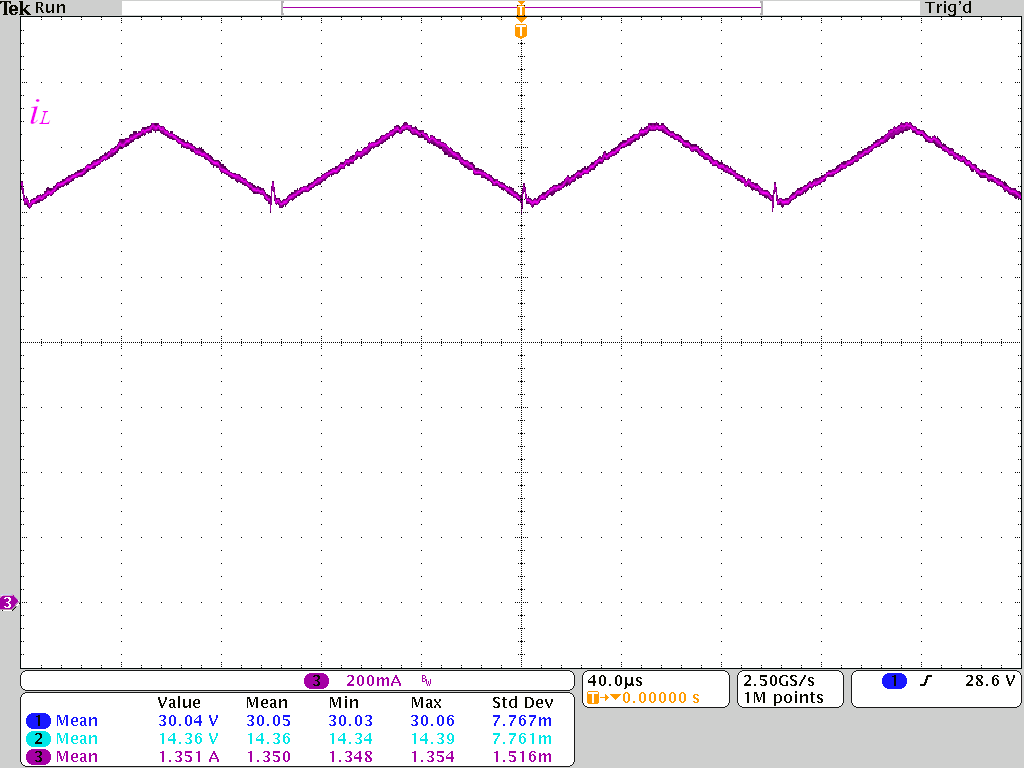
Imagens/Experimentos/iLmedio.png
