Pythorian/Conversor-Buck-Didatico/Imagens/Experimentos/RefCarga.png

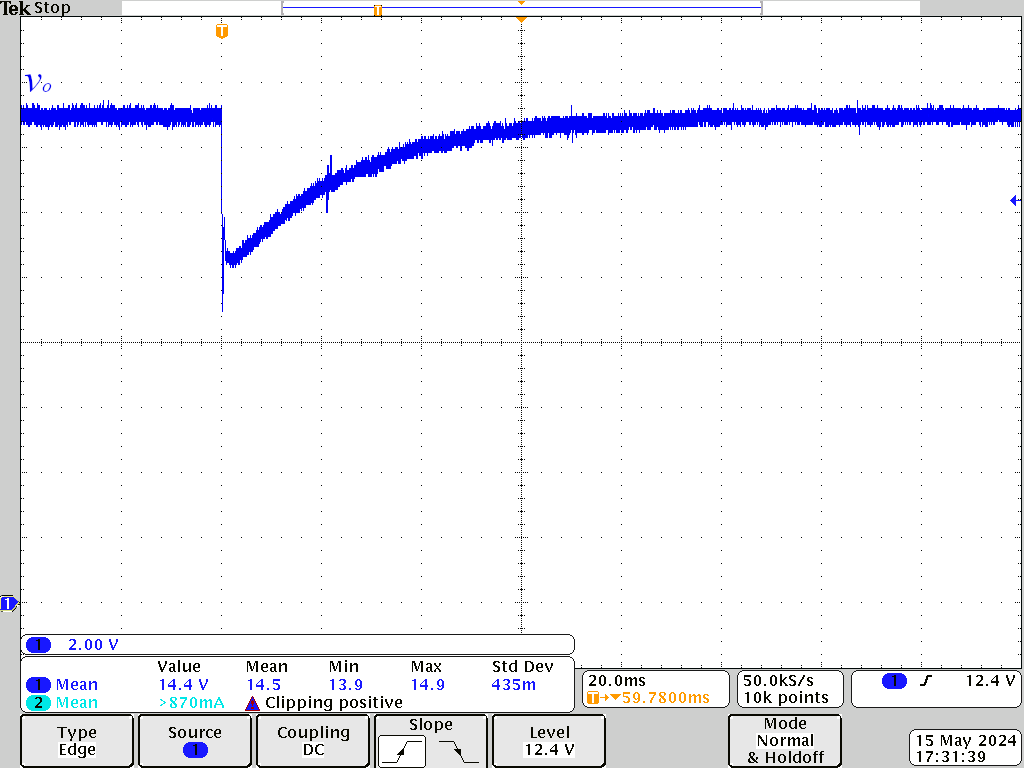
Imagens/Experimentos/RefCarga.png
