Pythorian/Conversor-Buck-Didatico/Imagens/Experimentos/RefCorrente.png

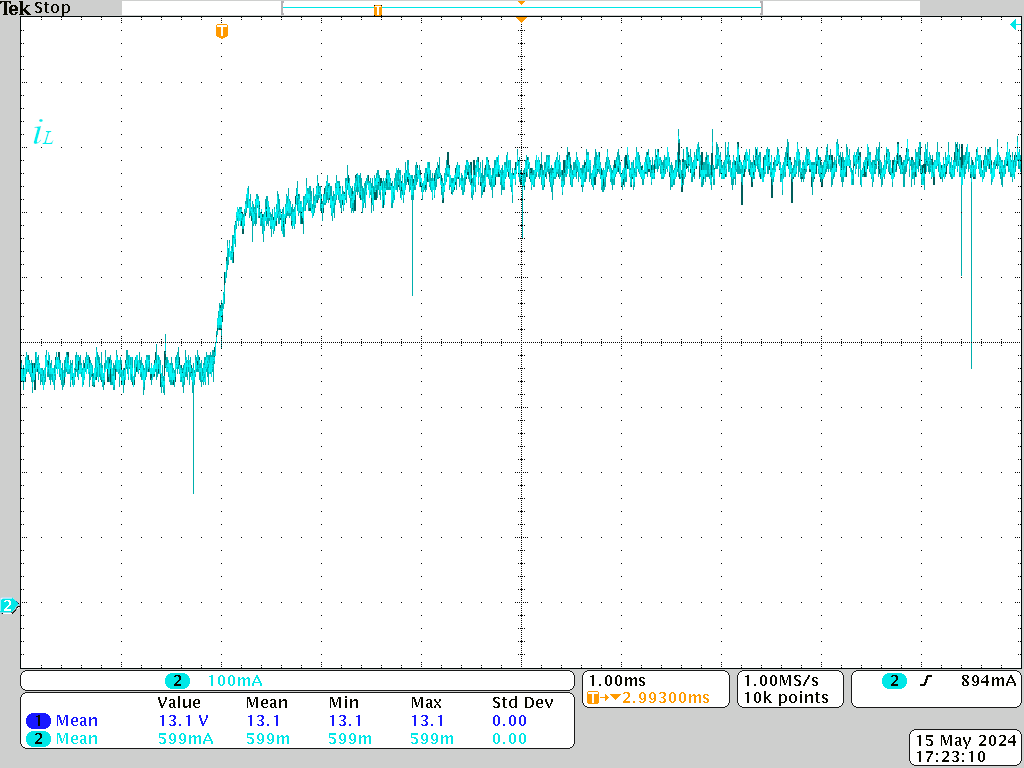
Imagens/Experimentos/RefCorrente.png
