Pythorian/Conversor-Buck-Didatico/Imagens/Experimentos/RefDutyCycle.png

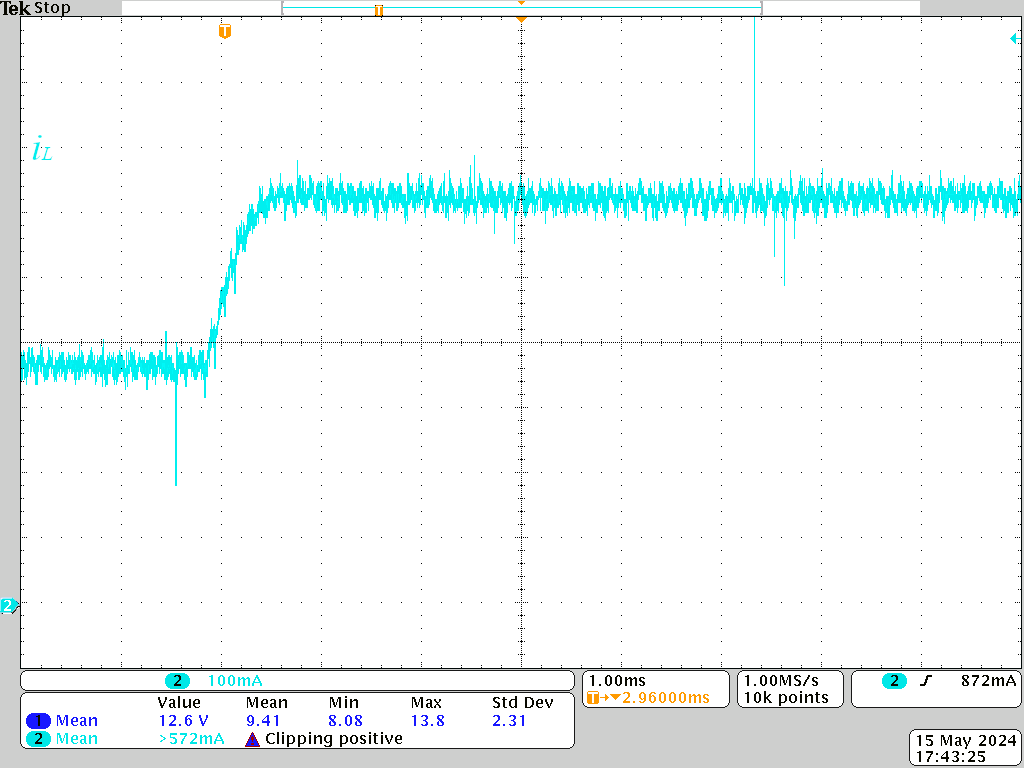
Imagens/Experimentos/RefDutyCycle.png
