Pythorian/Conversor-Buck-Didatico/Imagens/Experimentos/RefTensao.png

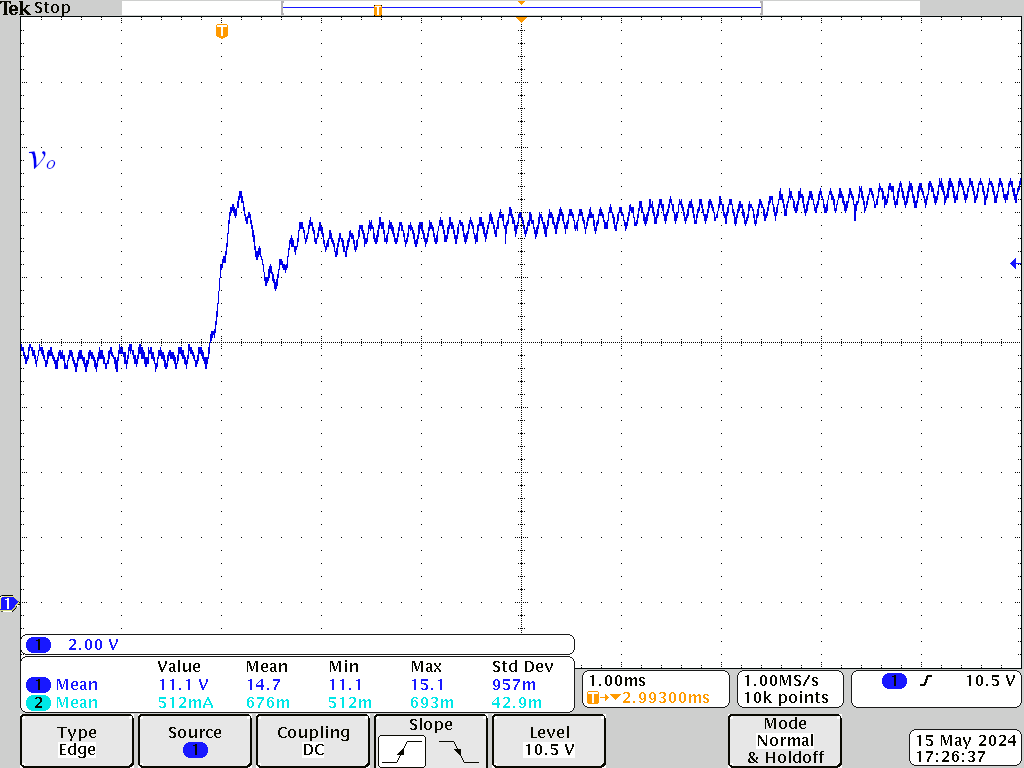
Imagens/Experimentos/RefTensao.png
