Pythorian/Conversor-Buck-Didatico/Imagens/Experimentos/VodeltaC1.png

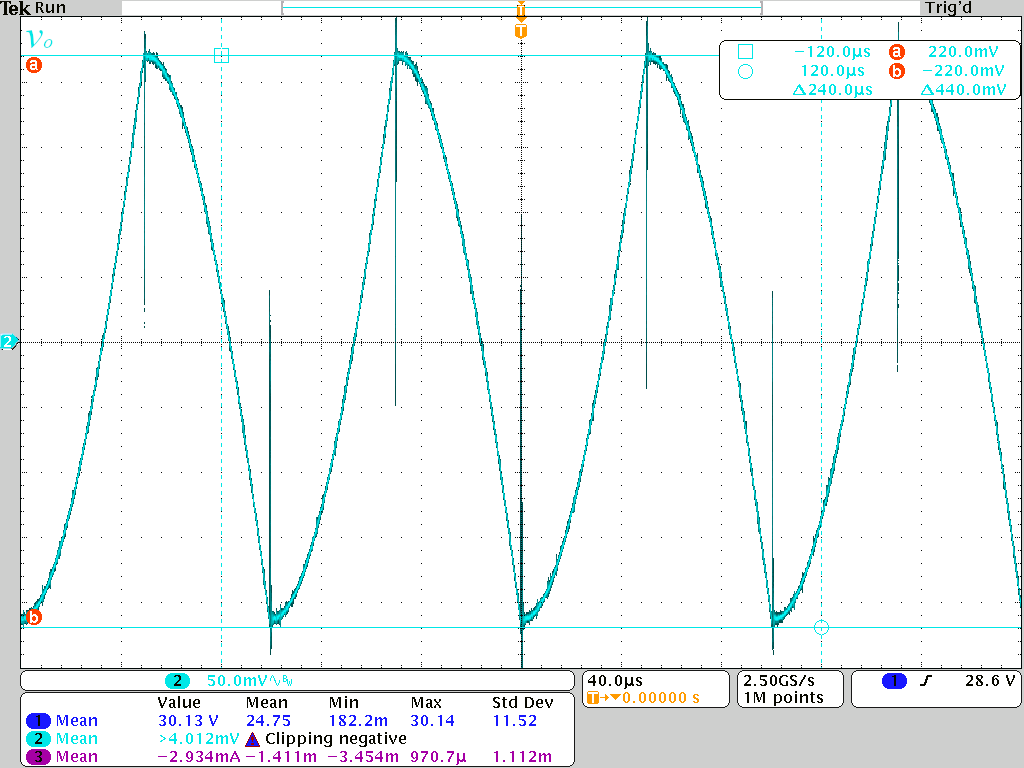
Imagens/Experimentos/VodeltaC1.png
