Pythorian/Conversor-Buck-Didatico/Imagens/Experimentos/VodeltaC2.png

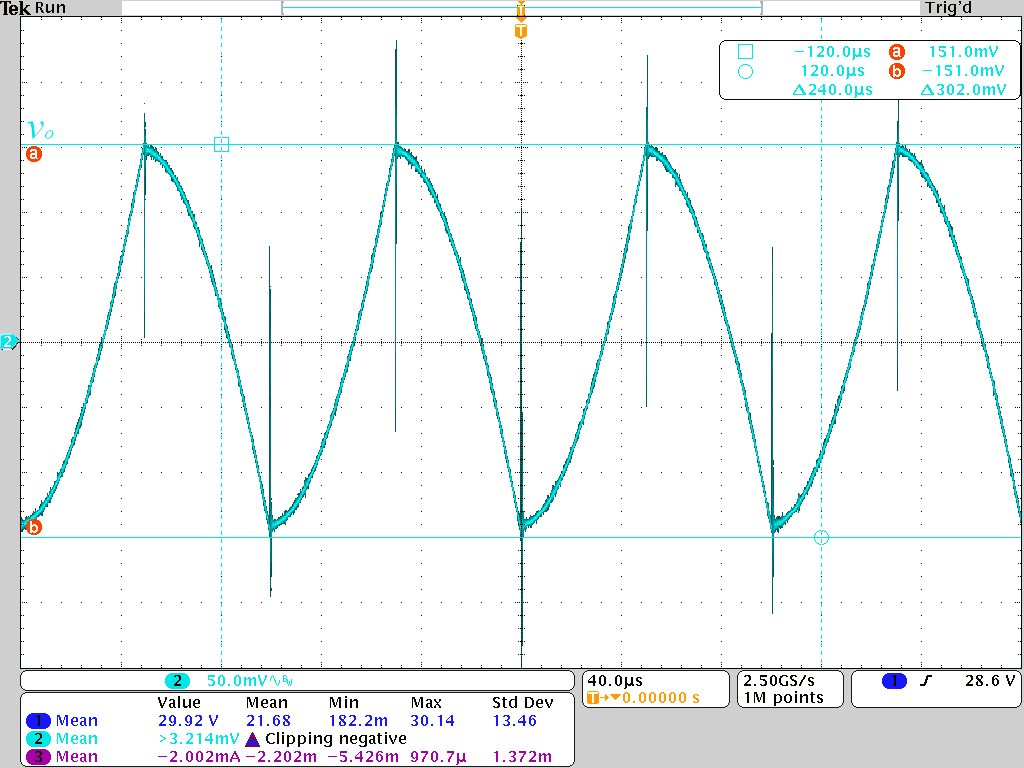
Imagens/Experimentos/VodeltaC2.png
