Pythorian/Conversor-Buck-Didatico/Imagens/Experimentos/VodeltaC3.png

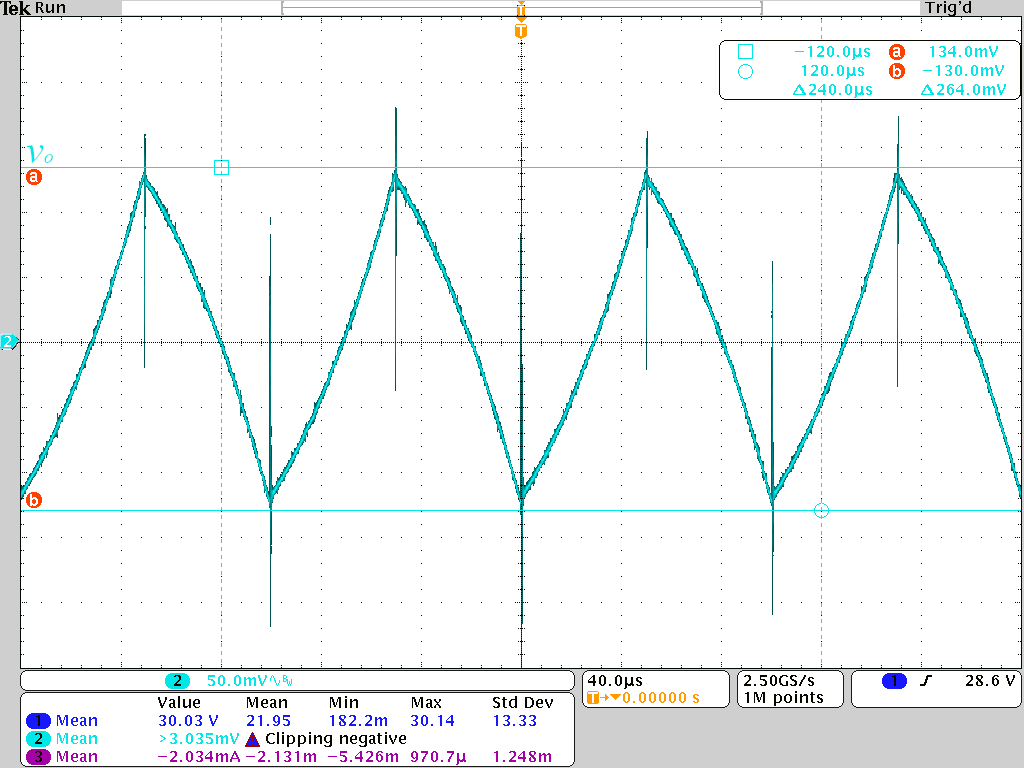
Imagens/Experimentos/VodeltaC3.png
