Pythorian/Conversor-Buck-Didatico/Imagens/Experimentos/VoVin.png

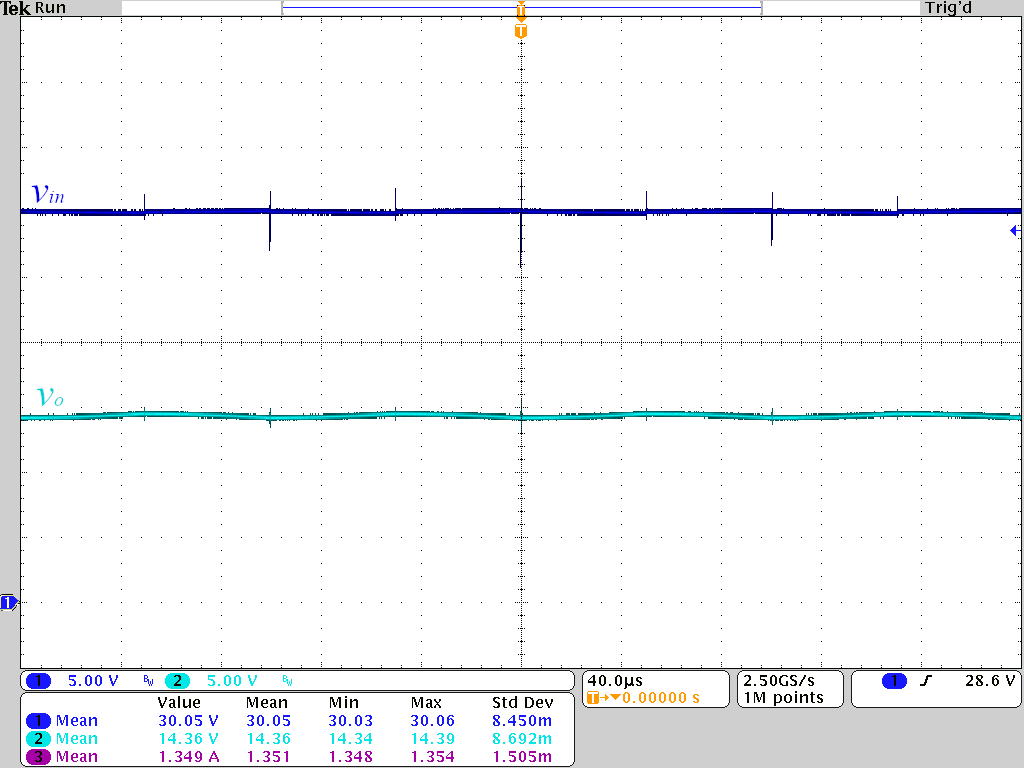
Imagens/Experimentos/VoVin.png
