Pythorian/Conversor-Buck-Didatico/Referências/engenharia/Scientech.pdf

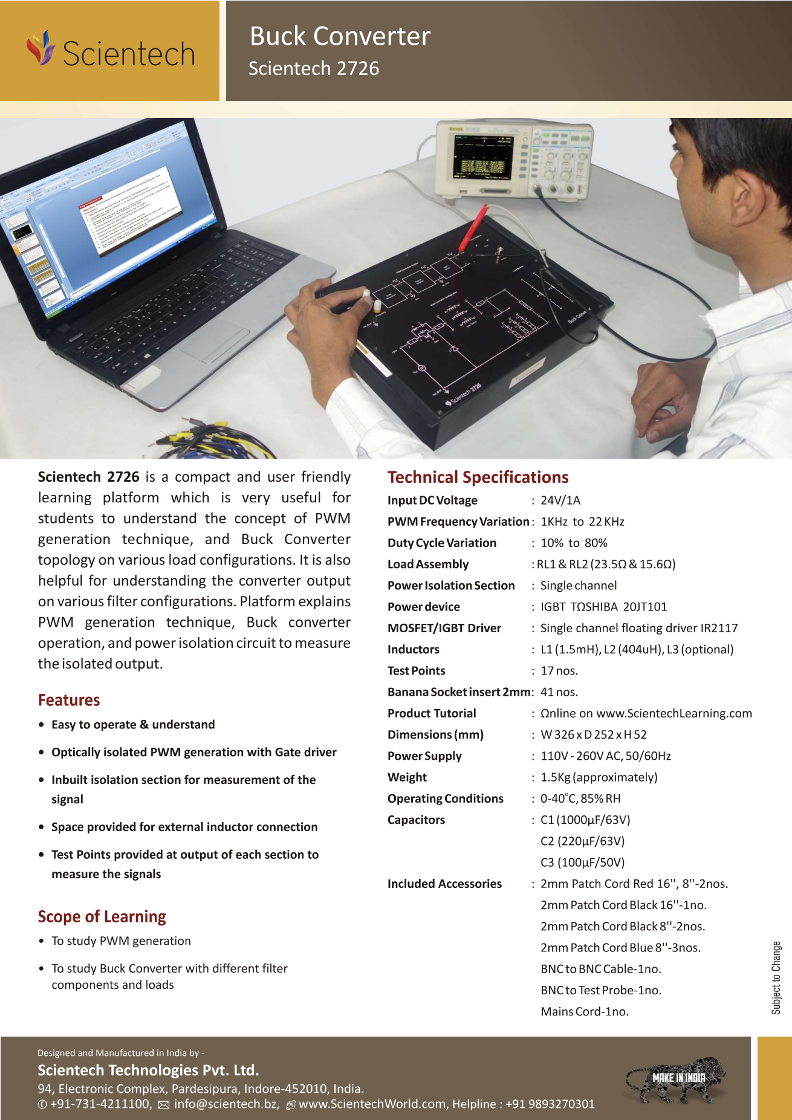
[picture p64: page 1]
