Pythorian/Conversor-Buck-Didatico/Placas/GateDriver/GateDriver.kicad_pcb

## KiCad design Placas/GateDriver/GateDriver.kicad_pcb (2024-05-31)

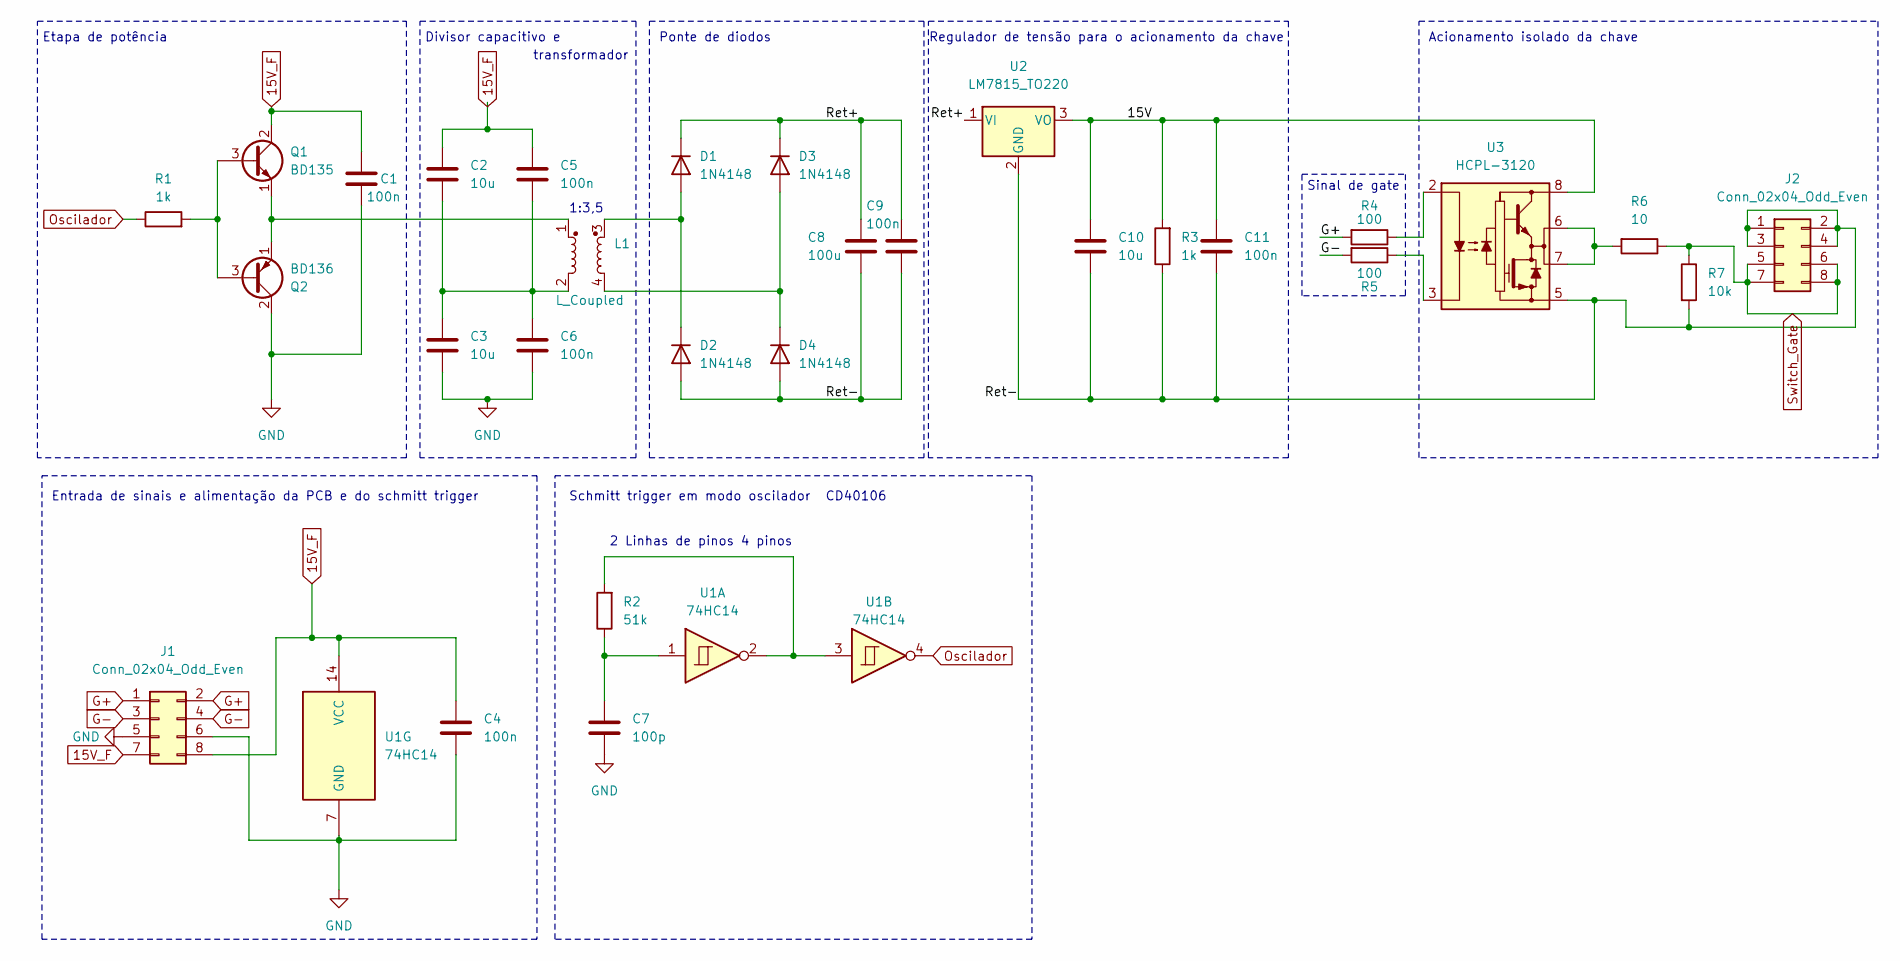
[picture p65: schematic GateDriver.kicad_sch]

Parts:
C1, C4, C5, C6, C9, C11: 100n; C_Disc_D5.0mm_W2.5mm_P5.00mm
C2, C3, C10: 10u; CP_Radial_D5.0mm_P2.00mm
C7: 100p; C_Disc_D5.0mm_W2.5mm_P5.00mm
C8: 100u; CP_Radial_D8.0mm_P3.50mm
D1, D2, D3, D4: 1N4148; D_DO-35_SOD27_P7.62mm_Horizontal
J1, J2: Conn_02x04_Odd_Even; PinHeader_2x04_P2.54mm_Horizontal
L1: L_Coupled; Inductor_Coupled
Q1: BD135; TO-126-3_Vertical
Q2: BD136; TO-126-3_Vertical
R1, R3: 1k; R_Axial_DIN0204_L3.6mm_D1.6mm_P7.62mm_Horizontal
R2: 51k; R_Axial_DIN0204_L3.6mm_D1.6mm_P7.62mm_Horizontal
R4, R5: 100; R_Axial_DIN0204_L3.6mm_D1.6mm_P7.62mm_Horizontal
R6: 10; R_Axial_DIN0204_L3.6mm_D1.6mm_P7.62mm_Horizontal
R7: 10k; R_Axial_DIN0204_L3.6mm_D1.6mm_P7.62mm_Horizontal
U1: 74HC14; DIP-14_W7.62mm_Socket
U2: LM7815_TO220; TO-220-3_Vertical
U3: HCPL-3120; DIP-8_W7.62mm_Socket

Connections:
15V_F: C1.1, C2.1, C4.1, C5.1, J1.7, J1.8, Q1.2 (C), U1.14 (VCC)
/15V: C10.1, C11.1, R3.2, U2.3 (VO), U3.8 (VCC)
/Ret+: C8.1, C9.1, D1.1 (K), D3.1 (K), U2.1 (VI)
/Ret-: C8.2, C9.2, C10.2, C11.2, D2.2 (A), D4.2 (A), J2.1, J2.2, J2.3, J2.4, R3.1, R7.2, U2.2 (GND), U3.5 (VEE)
G+: J1.1, J1.2, R4.2
G-: J1.3, J1.4, R5.2
GND: C1.2, C3.2, C4.2, C6.2, C7.2, J1.5, J1.6, Q2.2 (C), U1.7 (GND)
unnamed: C2.2, C3.1, C5.2, C6.1, L1.2
unnamed: C7.1, R2.1, U1.1
unnamed: D1.2 (A), D2.1 (K), L1.3
unnamed: D3.2 (A), D4.1 (K), L1.4
unnamed: Q1.3 (B), Q2.3 (B), R1.2
unnamed: L1.1, Q1.1 (E), Q2.1 (E)
unnamed: R2.2, U1.2, U1.3
unnamed: R6.2, U3.6 (VO), U3.7 (VO)
unnamed: R4.1, U3.2 (A)
unnamed: R5.1, U3.3 (C)
Oscilador: R1.1, U1.4
Switch_Gate: J2.5, J2.6, J2.7, J2.8, R6.1, R7.1

Notes on the sheet:
CD40106
transformador
1:3,5
Etapa de potência
Acionamento isolado da chave
Entrada de sinais e alimentação da PCB e do schmitt trigger
Divisor capacitivo e
Ponte de diodos
Schmitt trigger em modo oscilador
Sinal de gate
Regulador de tensão para o acionamento da chave
2 Linhas de pinos 4 pinos

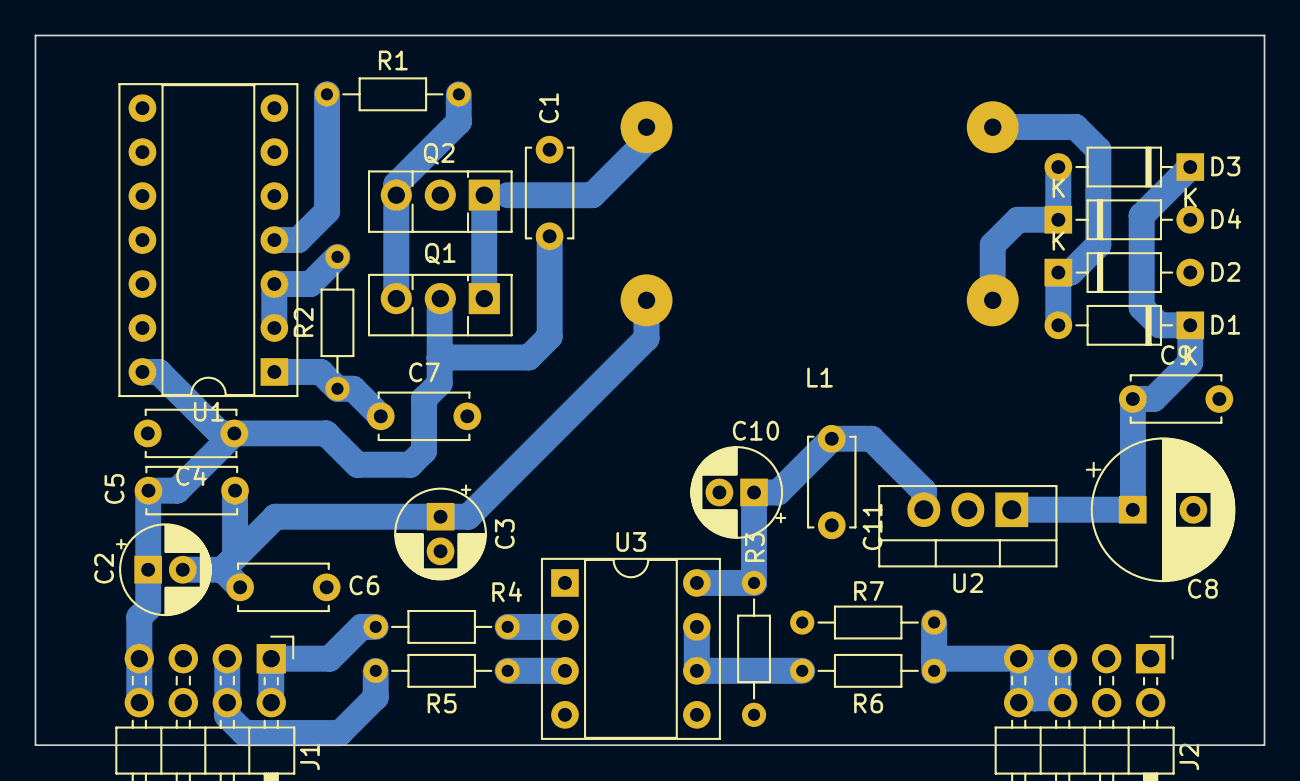
[picture p66: board GateDriver.kicad_pcb from above]

Board: 2 copper layers, 71.0 x 41.0 mm, 30 parts (0 on the bottom side), 19 nets.
