Pythorian/Conversor-Buck-Didatico/Placas/Instrumentação/Instrumentação.kicad_pcb

## KiCad design Placas/Instrumentação/Instrumentação.kicad_pcb (2024-05-31)

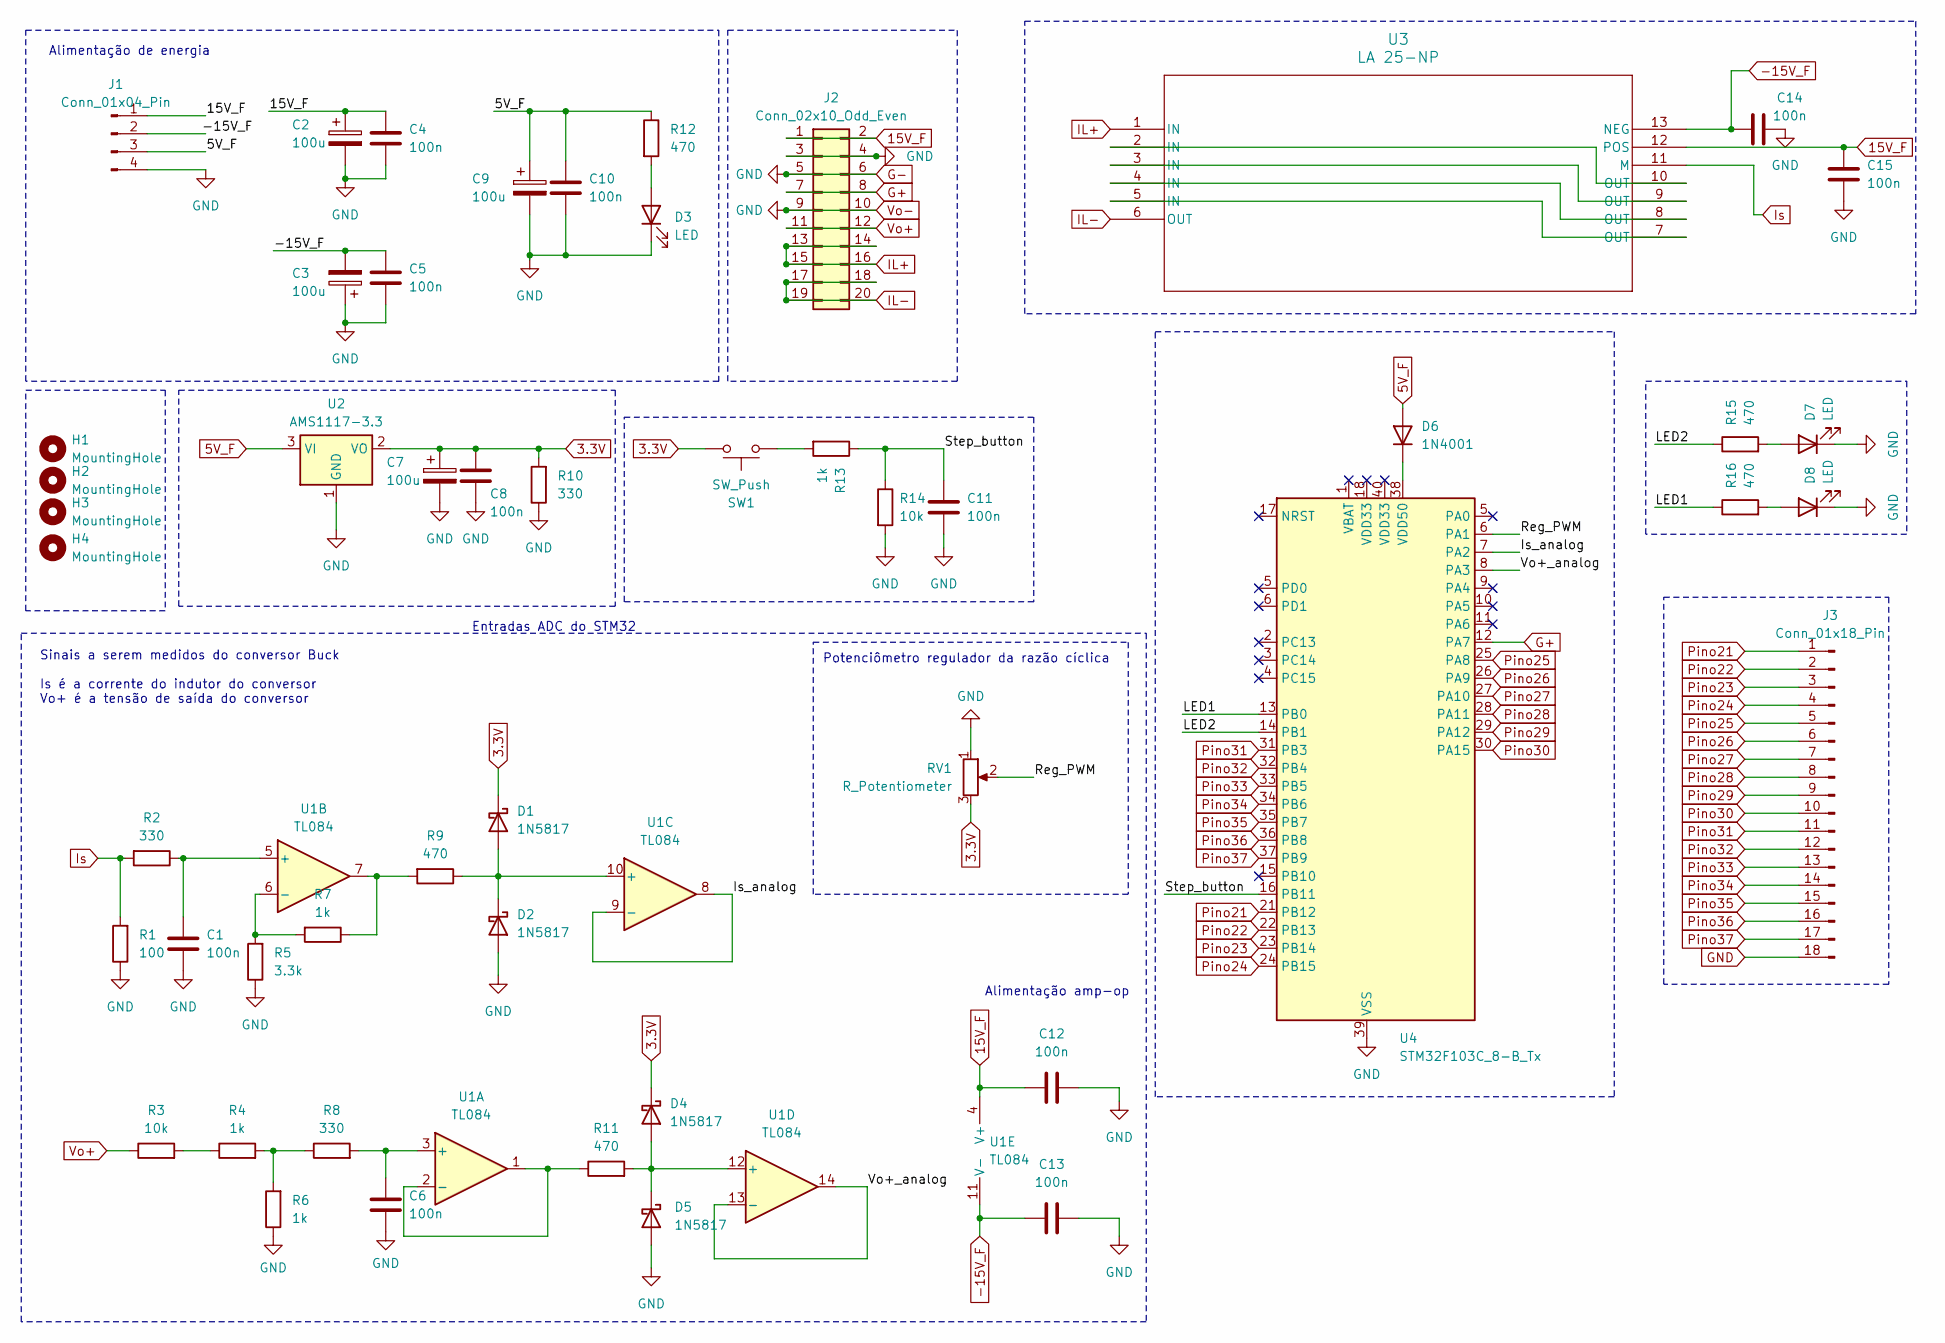
[picture p67: schematic Instrumentação.kicad_sch, Instrumentação conversor Buck didático]

Parts:
C1, C4, C5, C6, C8, C10, C11, C12, C13, C14, C15: 100n; C_Disc_D5.0mm_W2.5mm_P5.00mm
C2, C3, C7, C9: 100u; CP_Radial_D6.3mm_P2.50mm
D1, D2, D4, D5: 1N5817; D_DO-41_SOD81_P10.16mm_Horizontal
D3, D7, D8: LED; LED_D3.0mm
D6: 1N4001; D_DO-41_SOD81_P10.16mm_Horizontal
H1, H2, H3, H4: MountingHole; Furo
J1: Conn_01x04_Pin; Molex_KK-254_AE-6410-04A_1x04_P2.54mm_Vertical
J2: Conn_02x10_Odd_Even; PinHeader_2x10_P2.54mm_Horizontal
J3: Conn_01x18_Pin; PinHeader_1x18_P2.54mm_Vertical
R1: 100; R_Axial_DIN0204_L3.6mm_D1.6mm_P7.62mm_Horizontal
R2, R8, R10: 330; R_Axial_DIN0204_L3.6mm_D1.6mm_P7.62mm_Horizontal
R3, R14: 10k; R_Axial_DIN0204_L3.6mm_D1.6mm_P7.62mm_Horizontal
R4, R6, R7, R13: 1k; R_Axial_DIN0204_L3.6mm_D1.6mm_P7.62mm_Horizontal
R5: 3.3k; R_Axial_DIN0204_L3.6mm_D1.6mm_P7.62mm_Horizontal
R9, R11, R12, R15, R16: 470; R_Axial_DIN0204_L3.6mm_D1.6mm_P7.62mm_Horizontal
RV1: R_Potentiometer; Potentiometer_Alps_RK163_Single_Horizontal
SW1: SW_Push; SW_PUSH_6mm
U1: TL084; DIP-14_W7.62mm_Socket
U2: AMS1117-3.3; SOT-223-3_TabPin2
U3: LA 25-NP; LA 25-NP_LEM
U4: STM32F103C_8-B_Tx; DIP-40_W15.24mm_Socket_LongPads

Connections:
3.3V: C7.1, C8.2, D1.1 (K), D4.1 (K), R10.2, RV1.3, SW1.2, U2.2 (VO)
5V_F: C9.1, C10.2, D6.2 (A), J1.3, R12.1, U2.3 (VI)
15V_F: C2.1, C4.2, C12.1, C15.2, J1.1, J2.1, J2.2, U1.4 (V+), U3.12 (POS)
-15V_F: C3.2, C5.2, C13.1, C14.2, J1.2, U1.11 (V-), U3.13 (NEG)
/Is_analog: U1.8, U1.9 (-), U4.7 (PA2)
/LED1: R16.1, U4.13 (PB0)
/LED2: R15.1, U4.14 (PB1)
/Reg_PWM: RV1.2, U4.6 (PA1)
/Step_button: C11.2, R13.1, R14.1, U4.16 (PB11)
/Vo+_analog: U1.13 (-), U1.14, U4.8 (PA3)
G+: J2.7, J2.8, U4.12 (PA7)
G-: C1.1, C2.2, C3.1, C4.1, C5.1, C6.1, C7.2, C8.1, C9.2, C10.1, C11.1, C12.2, C13.2, C14.1, C15.1, D2.2 (A), D3.1 (K), D5.2 (A), D7.1 (K), D8.1 (K), J1.4, J2.3, J2.4, J2.5, J2.6, J2.9, J2.10, J3.18, R1.1, R5.1, R6.1, R10.1, R14.2, RV1.1, U2.1 (GND), U4.19 (VSS), U4.20 (VSS), U4.39 (VSS)
IL+: J2.13, J2.14, J2.15, J2.16, U3.1 (IN)
IL-: J2.17, J2.18, J2.19, J2.20, U3.6 (OUT)
Is: R1.2, R2.2, U3.11 (M)
unnamed: D1.2 (A), D2.1 (K), R9.1, U1.10 (+)
unnamed: D3.2 (A), R12.2
unnamed: D4.2 (A), D5.1 (K), R11.2, U1.12 (+)
unnamed: D6.1 (K), U4.38 (VDD50)
unnamed: D7.2 (A), R15.2
unnamed: D8.2 (A), R16.2
unnamed: R3.2, R4.1
unnamed: R4.2, R6.2, R8.1
unnamed: R7.1, R9.2, U1.7
unnamed: R13.2, SW1.1
unnamed: C6.2, R8.2, U1.3 (+)
unnamed: R11.1, U1.1, U1.2 (-)
unnamed: C1.2, R2.1, U1.5 (+)
unnamed: R5.2, R7.2, U1.6 (-)
unnamed: U3.2 (IN), U3.10 (OUT)
unnamed: U3.3 (IN), U3.9 (OUT)
unnamed: U3.4 (IN), U3.8 (OUT)
unnamed: U3.5 (IN), U3.7 (OUT)
Pino21: J3.1, U4.21 (PB12)
Pino22: J3.2, U4.22 (PB13)
Pino23: J3.3, U4.23 (PB14)
Pino24: J3.4, U4.24 (PB15)
Pino25: J3.5, U4.25 (PA8)
Pino26: J3.6, U4.26 (PA9)
Pino27: J3.7, U4.27 (PA10)
Pino28: J3.8, U4.28 (PA11)
Pino29: J3.9, U4.29 (PA12)
Pino30: J3.10, U4.30 (PA15)
Pino31: J3.11, U4.31 (PB3)
Pino32: J3.12, U4.32 (PB4)
Pino33: J3.13, U4.33 (PB5)
Pino34: J3.14, U4.34 (PB6)
Pino35: J3.15, U4.35 (PB7)
Pino36: J3.16, U4.36 (PB8)
Pino37: J3.17, U4.37 (PB9)
Vo+: J2.11, J2.12, R3.1

Notes on the sheet:
Alimentação de energia
Potenciômetro regulador da razão cíclica
Sinais a serem medidos do conversor Buck Is é a corrente do indutor do conversor Vo+ é a tensão de saída do conversor
Entradas ADC do STM32
Alimentação amp-op

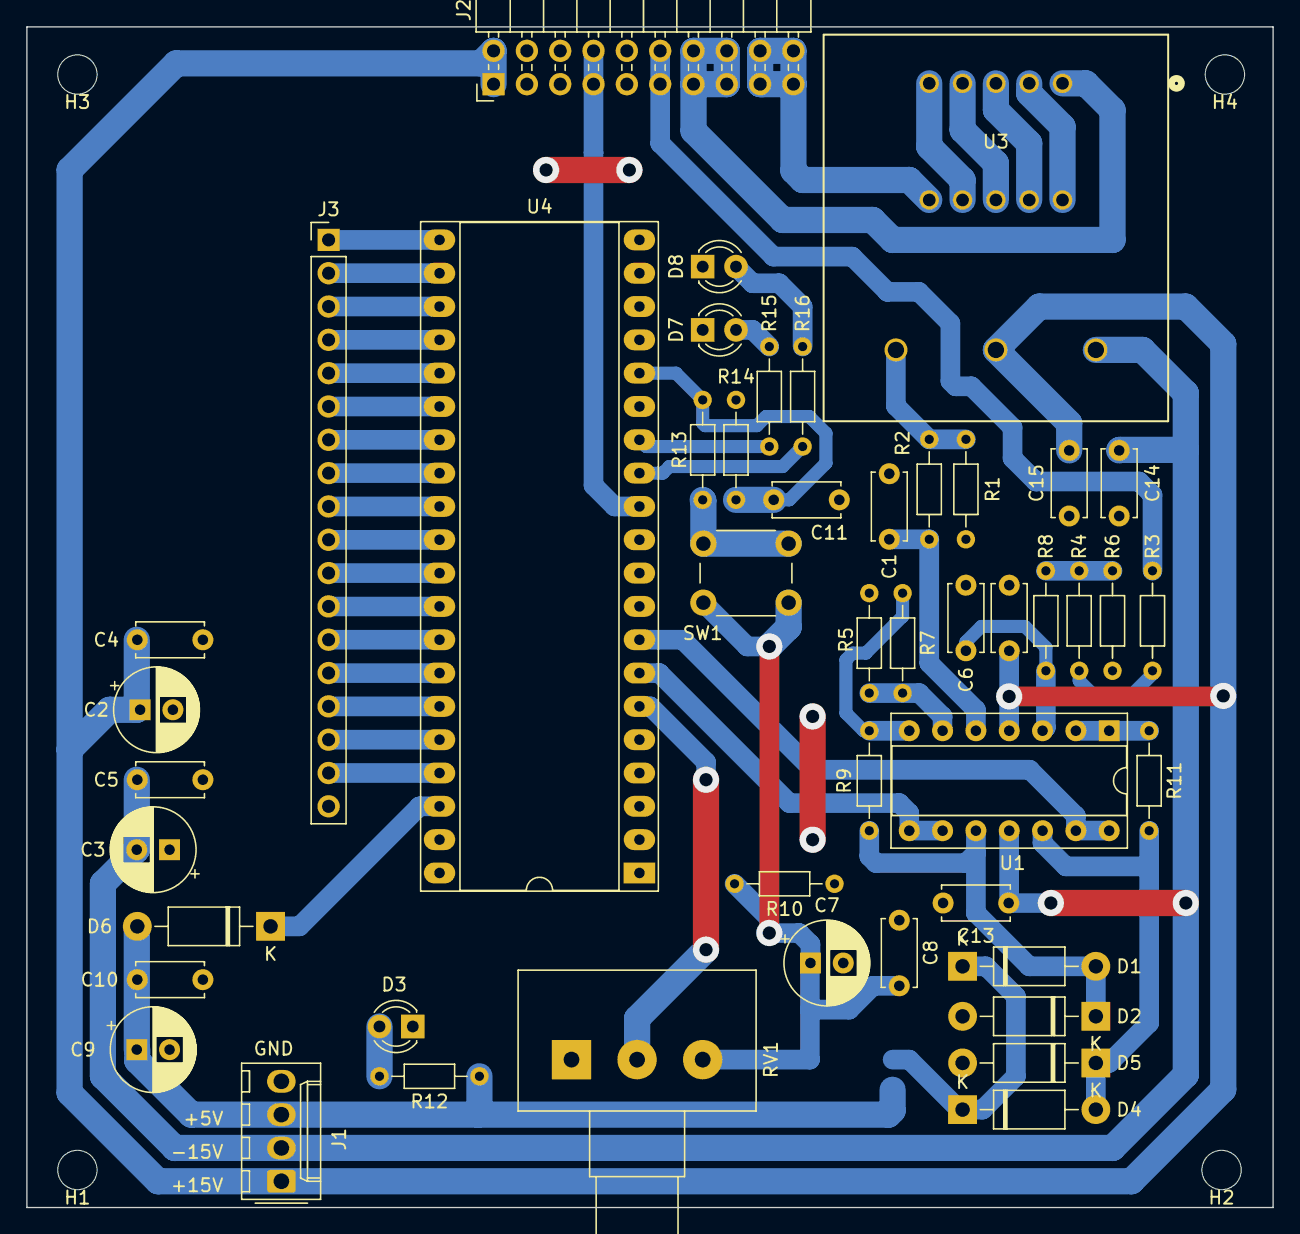
[picture p68: board Instrumentação.kicad_pcb from above]

Board: 2 copper layers, 95.0 x 90.0 mm, 52 parts (1 on the bottom side), 51 nets.
