Pythorian/Conversor-Buck-Didatico/Placas/FonteAlimentacaoTCC/FonteAlimentacaoTCC.kicad_pcb

## KiCad design Placas/FonteAlimentacaoTCC/FonteAlimentacaoTCC.kicad_pcb (2024-04-08)

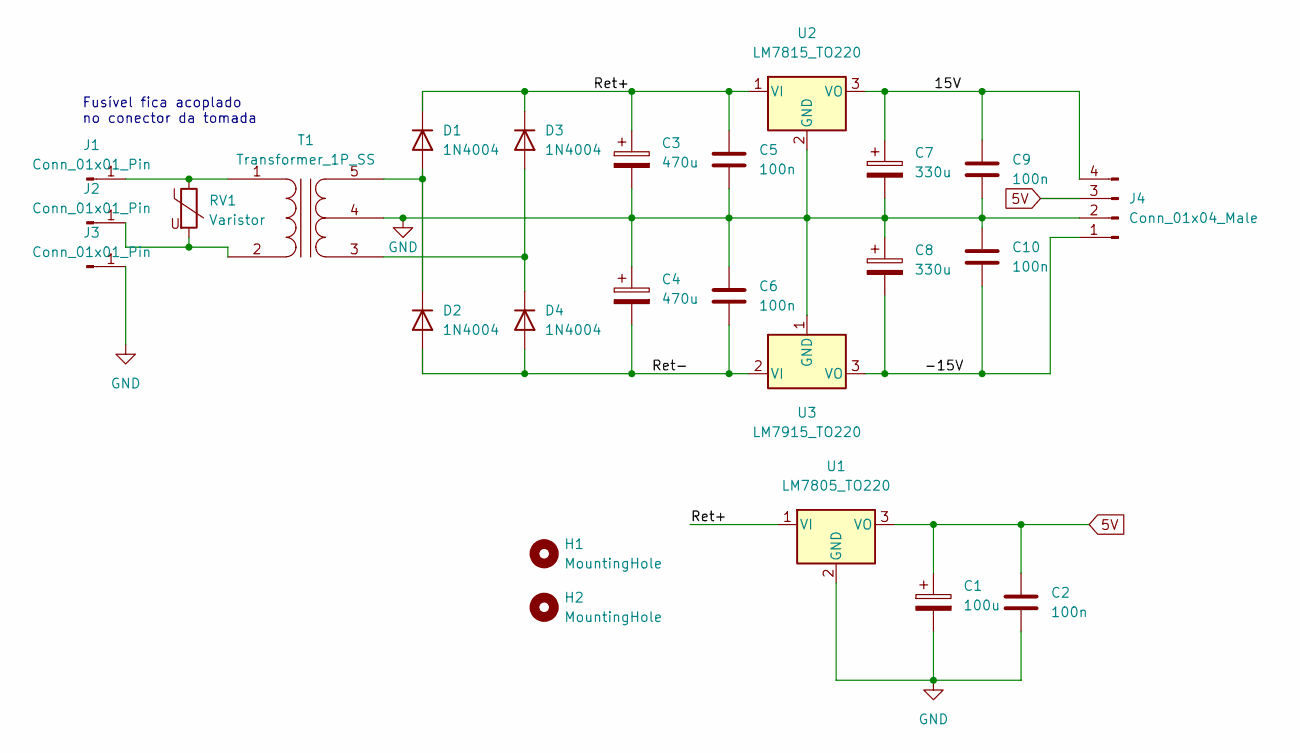
[picture p69: schematic FonteAlimentacaoTCC.kicad_sch]

Parts:
C1: 100u; CP_Radial_D8.0mm_P3.50mm
C2, C5, C6, C9, C10: 100n; C_Disc_D5.0mm_W2.5mm_P5.00mm
C3, C4: 470u; CP_Radial_D13.0mm_P5.00mm
C7, C8: 330u; CP_Radial_D10.0mm_P5.00mm
D1, D2, D3, D4: 1N4004; D_DO-41_SOD81_P10.16mm_Horizontal
H1, H2: MountingHole; parafuso
J1, J2, J3: Conn_01x01_Pin; entrada
J4: Conn_01x04_Male; conector_saida
RV1: Varistor; RV_Disc_D9mm_W3.3mm_P5mm
T1: Transformer_1P_SS; transformador
U1: LM7805_TO220; TO-220-3_Vertical
U2: LM7815_TO220; TO-220-3_Vertical
U3: LM7915_TO220; TO-220-3_Vertical

Connections:
5V: C1.1, C2.1, J4.3, U1.3 (VO)
/15V: C7.1, C9.1, J4.4, U2.3 (VO)
/-15V: C8.2, C10.2, J4.1, U3.3 (VO)
/Ret+: C3.1, C5.1, D1.1 (K), D3.1 (K), U1.1 (VI), U2.1 (VI)
/Ret-: C4.2, C6.2, D2.2 (A), D4.2 (A), U3.2 (VI)
GND: C1.2, C2.2, C3.2, C4.1, C5.2, C6.1, C7.2, C8.1, C9.2, C10.1, J3.1, J4.2, T1.4 (SC), U1.2 (GND), U2.2 (GND), U3.1 (GND)
unnamed: D1.2 (A), D2.1 (K), T1.5 (SB)
unnamed: D3.2 (A), D4.1 (K), T1.3 (SA)
unnamed: J1.1, RV1.1, T1.1 (AA)
unnamed: J2.1, RV1.2, T1.2 (AB)

Notes on the sheet:
Fusível fica acoplado no conector da tomada

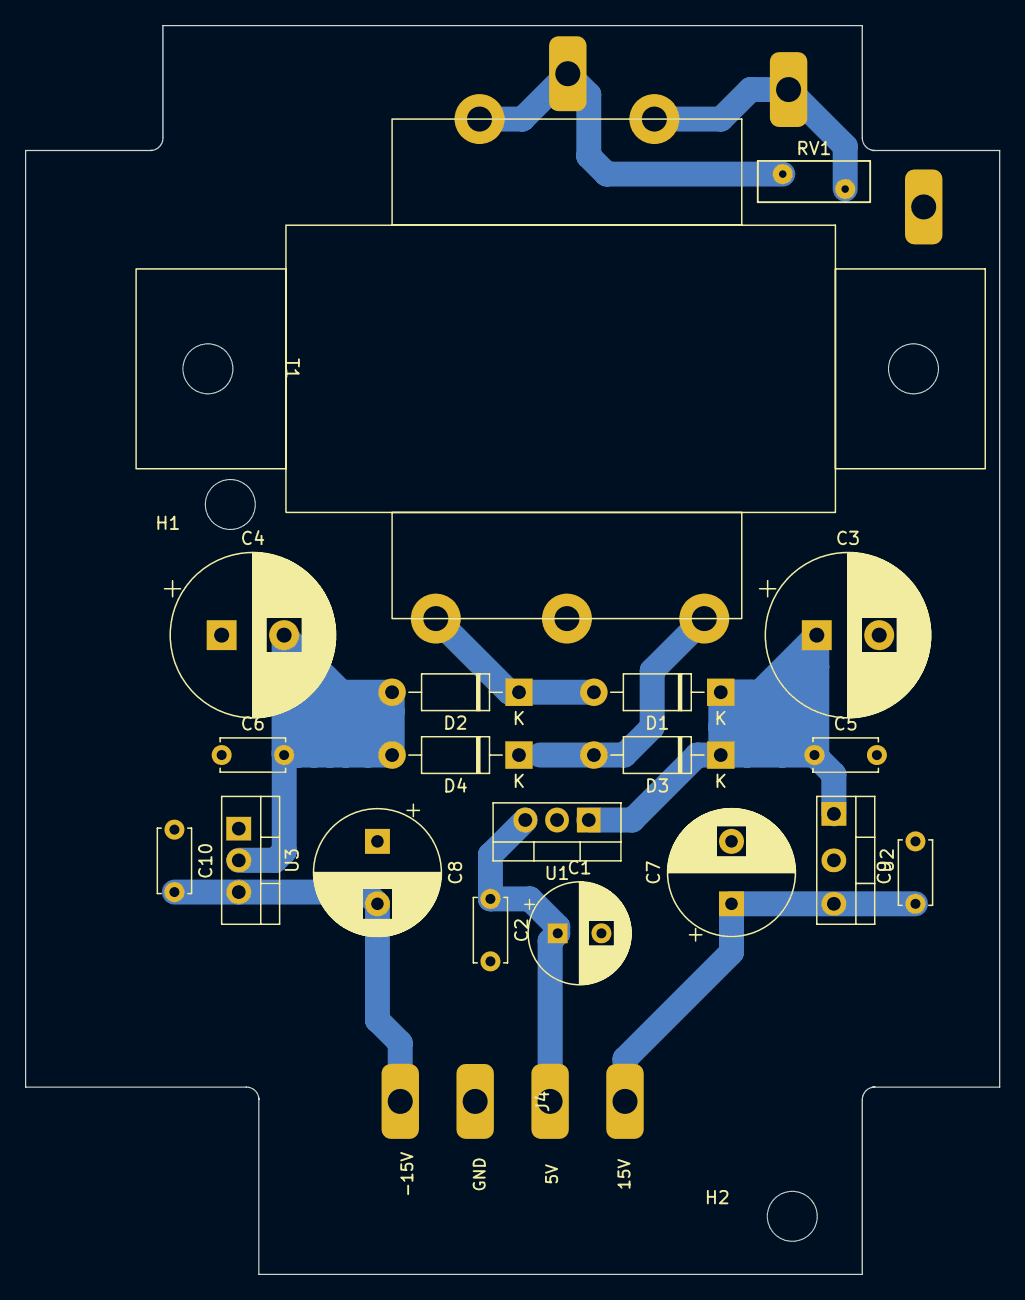
[picture p70: board FonteAlimentacaoTCC.kicad_pcb from above]

Board: 2 copper layers, 78.0 x 100.0 mm, 25 parts (0 on the bottom side), 10 nets.
