Pythorian/Conversor-Buck-Didatico/Placas/Buck/Buck.kicad_pcb

## KiCad design Placas/Buck/Buck.kicad_pcb (2024-04-08)

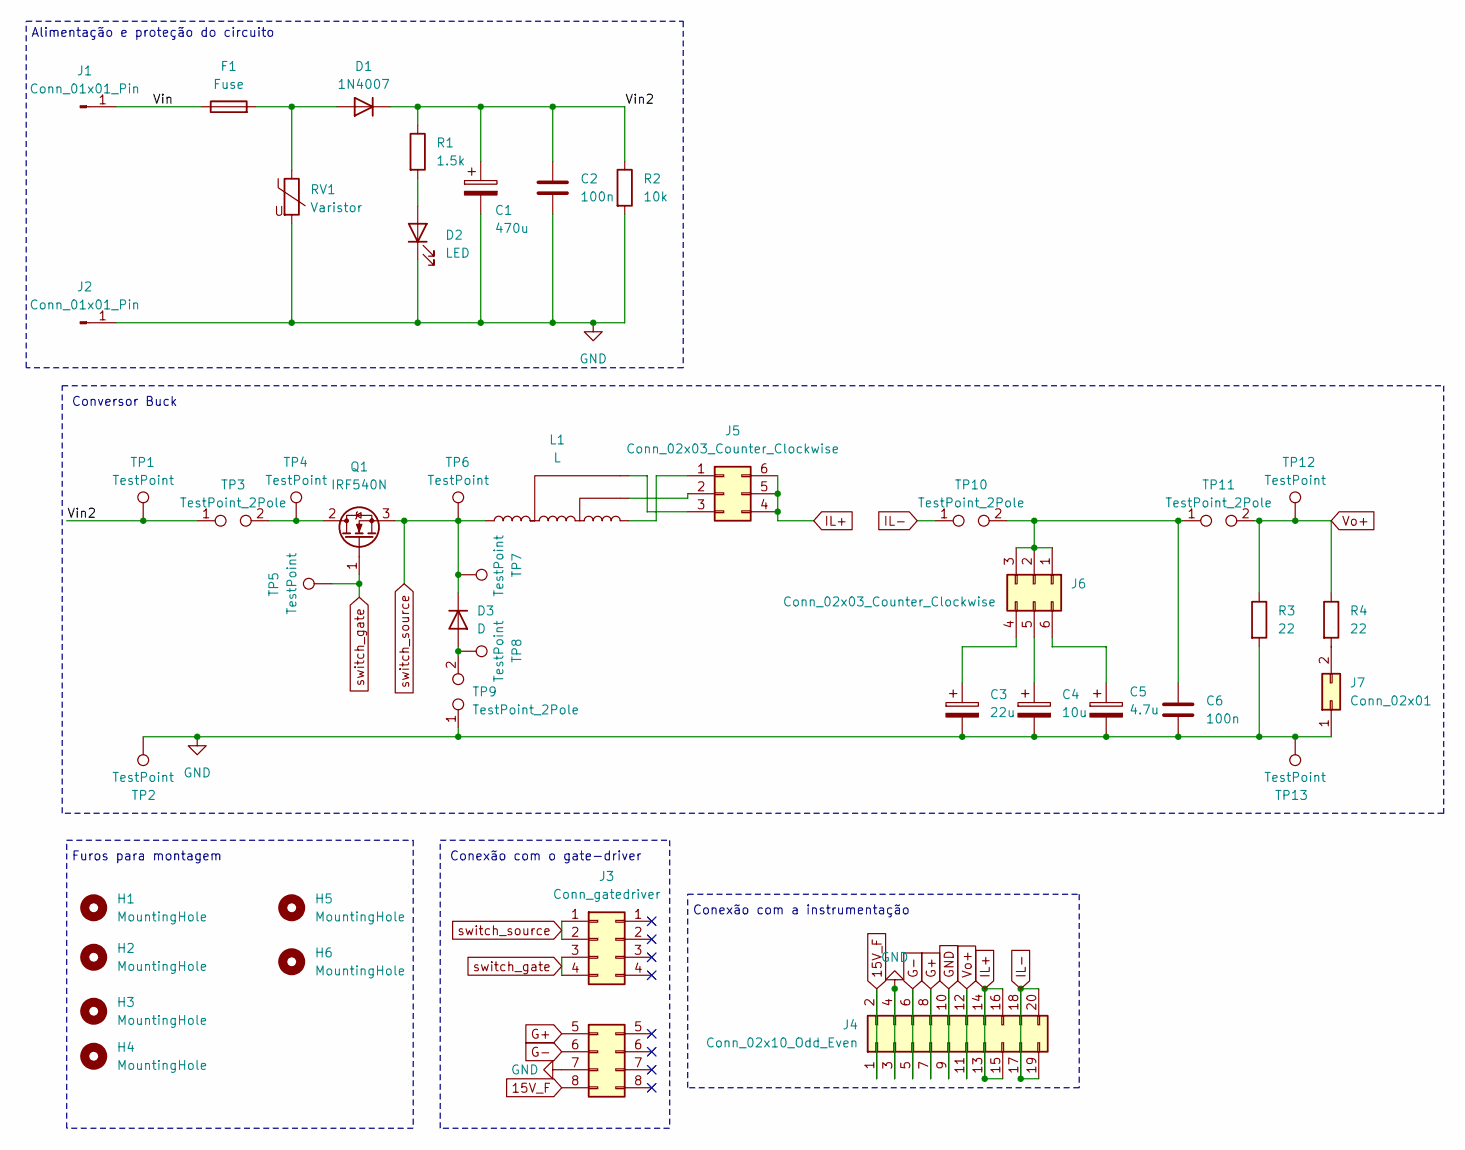
[picture p71: schematic Buck.kicad_sch]

Parts:
C1: 470u; CP_Radial_D16.0mm_P7.50mm
C2, C6: 100n; C_Disc_D5.0mm_W2.5mm_P5.00mm
C3: 22u; CP_Radial_D6.3mm_P2.50mm
C4: 10u; CP_Radial_D5.0mm_P2.00mm
C5: 4.7u; CP_Radial_D5.0mm_P2.00mm
D1: 1N4007; D_DO-41_SOD81_P10.16mm_Horizontal
D2: LED; LED_D3.0mm
D3: D; TO-220-2_Horizontal_TabDown
F1: Fuse
H1, H2, H3, H4, H5, H6: MountingHole; Furo
J1, J2: Conn_01x01_Pin; Banana_Jack_1Pin
J3: Conn_gatedriver; GateDriver
J4: Conn_02x10_Odd_Even; PinSocket_2x10_P2.54mm_Horizontal
J5, J6: Conn_02x03_Counter_Clockwise; PinHeader_2x03_P2.54mm_Vertical
J7: Conn_02x01; PinHeader_2x02_P2.54mm_Vertical
L1: L; Inductor_buck
Q1: IRF540N; TO-220-3_Horizontal_TabDown
R1: 1.5k; R_Axial_DIN0204_L3.6mm_D1.6mm_P7.62mm_Horizontal
R2: 10k; R_Axial_DIN0204_L3.6mm_D1.6mm_P7.62mm_Horizontal
R3, R4: 22; R_Axial_Power_L38.0mm_W9.0mm_P45.72mm
RV1: Varistor; RV_Disc_D7mm_W3.4mm_P5mm
TP1, TP2, TP4, TP5, TP6, TP7, TP8, TP12, TP13: TestPoint; TestPoint_Loop_D2.60mm_Drill1.6mm_Beaded
TP3, TP9, TP10, TP11: TestPoint_2Pole; Testpoint_current

Connections:
15V_F: J3.8 (Pin_15), J4.1, J4.2
G+: J3.5 (Pin_9), J4.7, J4.8
G-: J3.6 (Pin_11), J4.5, J4.6
GND: C1.2, C2.2, C3.2, C4.2, C5.2, C6.2, D2.1 (K), J2.1, J3.7 (Pin_13), J4.3, J4.4, J4.9, J4.10, J7.1, R2.2, R3.2, RV1.2, TP2.1, TP9.1, TP13.1; also elsewhere on the board
IL+: J4.13, J4.14, J4.15, J4.16, J5.4, J5.5, J5.6
IL-: J4.17, J4.18, J4.19, J4.20, TP10.1
unnamed: D1.2 (A), F1.2, RV1.1
unnamed 7: C1.1, C2.1, D1.1 (K), R1.1, R2.1, TP1.1, TP3.1; also elsewhere on the board
unnamed: D2.2 (A), R1.2
unnamed: D3.2 (A), TP8.1, TP9.2
unnamed: F1.1, J1.1
unnamed: J5.1, L1.4
unnamed: J5.2, L1.3
unnamed: J5.3, L1.2
unnamed: C6.1, J6.1, J6.2, J6.3, TP10.2, TP11.1
unnamed: C3.1, J6.4
unnamed: C4.1, J6.5
unnamed: C5.1, J6.6
unnamed 18: J7.2, R4.2; also elsewhere on the board
unnamed: Q1.2 (D), TP3.2, TP4.1
Vo+: J4.11, J4.12, R3.1, R4.1, TP11.2, TP12.1; also elsewhere on the board
switch_gate: J3.3 (Pin_5), J3.4 (Pin_7), Q1.1 (G), TP5.1
switch_source: D3.1 (K), J3.1, J3.2 (Pin_3), L1.1, Q1.3 (S), TP6.1, TP7.1

Notes on the sheet:
Conversor Buck
Conexão com o gate-driver
Alimentação e proteção do circuito
Furos para montagem
Conexão com a instrumentação

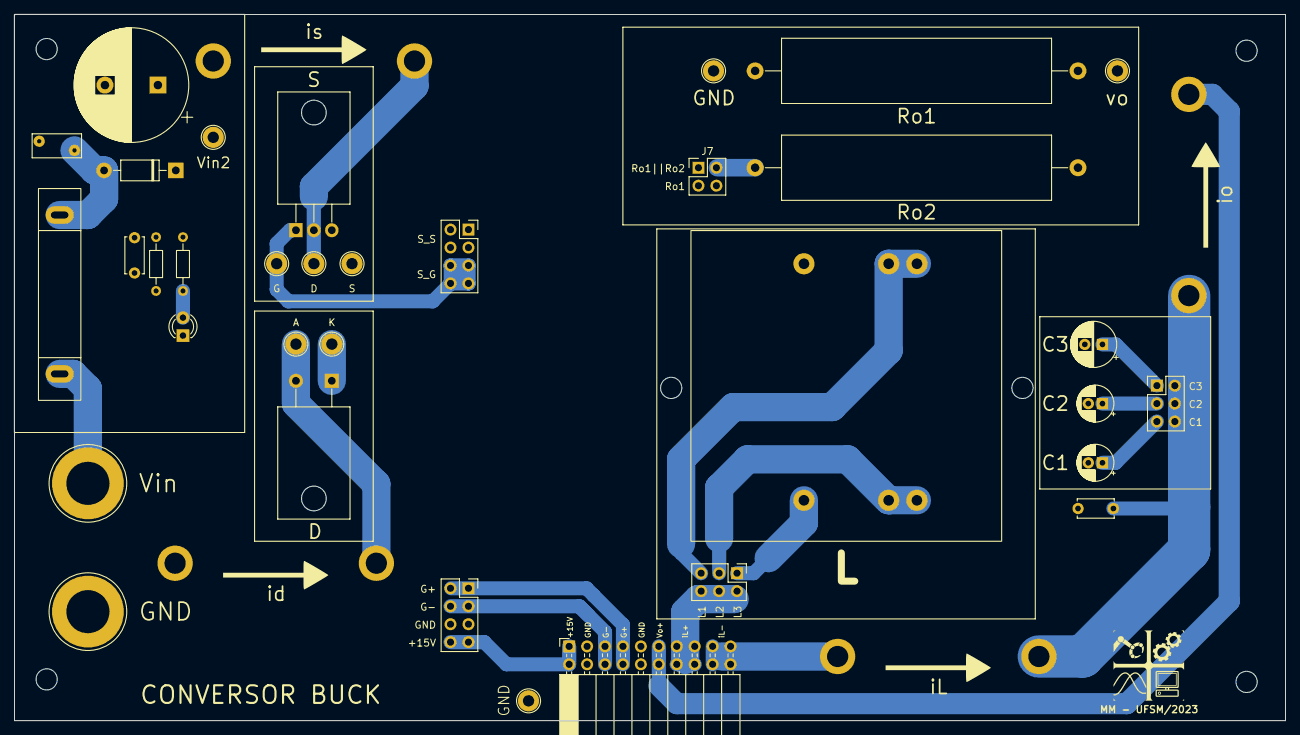
[picture p72: board Buck.kicad_pcb from above]

Board: 2 copper layers, 180.0 x 100.0 mm, 43 parts (0 on the bottom side), 23 nets.

Other parts of the board:
Ro1, Ro2: 22; R_Axial_Power_L38.0mm_W9.0mm_P45.72mm
Vin2: TestPoint; TestPoint_Loop_D2.60mm_Drill1.6mm_Beaded

Their connections:
GND: Ro1.2; also elsewhere on the board
unnamed 7: Vin2.1; also elsewhere on the board
unnamed 18: Ro2.2; also elsewhere on the board
Vo+: Ro1.1, Ro2.1; also elsewhere on the board
