Pythorian/Conversor-Buck-Didatico/CubeIDE/main.c

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
/* Includes ------------------------------------------------------------------*/
#include "main.h"

/* USER CODE BEGIN Includes */
#include "string.h"
#include "stdlib.h"
#include "math.h"
#include "stdio.h"
/* USER CODE END Includes */

/* USER CODE BEGIN PD */
#define ADC_BUF_SIZE 3
/* USER CODE END PD */

ADC_HandleTypeDef hadc1;
DMA_HandleTypeDef hdma_adc1;

TIM_HandleTypeDef htim3;

UART_HandleTypeDef huart1;

/* USER CODE BEGIN PV */

//-------------------------------------------//
// Declaracao de variaveis para a leitura ADC//
//-------------------------------------------//
float pot_malha_aberta = 0.0f;
float pot_corrente = 0.0f;
float pot_tensao = 0.0f;
float corrente = 0.0f;
float tensao = 0.0f;
uint16_t ref_pwm = 0;

float ganho_pot_malha_aberta = 0.439560439f;//1800/4095
float ganho_pot_corrente = 0.0001663f; // 0.681A/4095
float ganho_pot_tensao = 3.663e-3f; // 15V/4095
float ganho_corrente = 1.25031e-3f; // 5.12A/4095
float ganho_tensao = 9.76801e-3f; // 40V/4095

float pot_adc = 0.0f;
float corrente_adc = 0.0f;
float tensao_adc = 0.0f;

volatile uint8_t FLAG_READY=0;

volatile uint16_t ADC_buffer[ADC_BUF_SIZE];

//-------Variaveis para comunicacao serial--//
uint16_t SERIAL_DELAY = 1000;
uint8_t SERIAL_TIMES = 0;
//------------------------------------------//


//--------------------------------------------//
// Declaracao variaveis controle              //
//-------------------------------------------//
static float uik0, uik1;
static float eik0, eik1;

static float uvk0, uvk1;
static float evk0, evk1;

static float iL, iLref, Vo, Voref;


//Ganhos do compensador de corrente
const float ai1 = 3.64182649500560e+003;
const float ai2 = -3.41997350499440e+003f;

//Ganhos do compensador de tensao
const float av1 = 44.8243789261330e-003f;
const float av2 = -44.5436210738670e-003f;

/* USER CODE END PV */

void SystemClock_Config(void);
static void MX_GPIO_Init(void);
static void MX_DMA_Init(void);
static void MX_ADC1_Init(void);
static void MX_TIM3_Init(void);
static void MX_USART1_UART_Init(void);
/* USER CODE BEGIN PFP */
void HAL_TIM_PeriodElapsedCallback(TIM_HandleTypeDef *htim);

/* USER CODE END PFP */

/**
  * @brief  The application entry point.
  * @retval int
  */
int main(void)
{

  /* MCU Configuration--------------------------------------------------------*/

  /* Reset of all peripherals, Initializes the Flash interface and the Systick. */
  HAL_Init();

  /* Configure the system clock */
  SystemClock_Config();

  /* Initialize all configured peripherals */
  MX_GPIO_Init();
  MX_DMA_Init();
  MX_ADC1_Init();
  MX_TIM3_Init();
  MX_USART1_UART_Init();
  /* USER CODE BEGIN 2 */

  //Calibracao do ADC
  HAL_ADCEx_Calibration_Start(&hadc1);

  //Inicializa o sinal pwm e a interrupcao pelo timer3
  HAL_TIM_Base_Start_IT(&htim3); // inicializa a interrupção pelo timer 3
  HAL_TIM_PWM_Start(&htim3, TIM_CHANNEL_2); // inicializa o PWM


  /* USER CODE END 2 */

  /* Infinite loop */
  /* USER CODE BEGIN WHILE */


  while (1)
  {
    /* USER CODE END WHILE */

    /* USER CODE BEGIN 3 */
  }
  /* USER CODE END 3 */
}

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
/* USER CODE BEGIN 4 */


//----------------------------------------------//
//    Funcao que executa a leitura dos ADCs     //
//----------------------------------------------//
void read_ADC()
{

	// Ler ADCs
	FLAG_READY = 0; // Zerar a FLAG de "leitura dos adcs"


	HAL_ADC_Start_DMA(&hadc1, (uint32_t*) ADC_buffer, ADC_BUF_SIZE); // Dispara a leitura da leitura do ADC
//	while(FLAG_READY == 0); // Espera a flag do "leitura dos adcs" ser 1 (leitura realizada)

	ref_pwm = ADC_buffer[0];
	pot_adc = ADC_buffer[0];
	corrente_adc = ADC_buffer[1];
	tensao_adc = ADC_buffer[2];

	pot_malha_aberta = pot_adc*ganho_pot_malha_aberta; //multiplica o sinal lido pelo pino adc do potenciometro pelo seu ganho para utilizar em malha aberta
	pot_corrente = pot_adc*ganho_pot_corrente; //multiplica o sinal lido pelo pino adc do potenciometro pelo seu ganho para utilizar como referencia de corrente
	pot_tensao = pot_adc*ganho_pot_tensao; //multiplica o sinal lido pelo pino adc do potenciometro pelo seu ganho para utilizar como referencia de tensao
	corrente  = corrente_adc*ganho_corrente; //multiplica o sinal lido pelo pino adc da corrente pelo seu ganho definido no inicio do código
	tensao  = tensao_adc*ganho_tensao; //multiplica o sinal lido pelo pino adc da tensao pelo seu ganho definido no inicio do código

}

// Funcao de debug atraves do protocolo usart para leitura na serial dos valores dos adcs
void print_MSG()
{

	char mensagemUart[500];
	sprintf(mensagemUart, "%4.2f %4.2f %4.2f \r\n", pot_malha_aberta, corrente, tensao);
	HAL_UART_Transmit(&huart1, (const uint8_t*) mensagemUart, strlen(mensagemUart), 1000);
}

//Função para printar uma variável qualquer na serial como debug atraves do protocolo usart
void debug_msg(float mensagem)
{
	char mensagemUart[500];
	sprintf(mensagemUart, "%4.2f \r\n", mensagem);
	HAL_UART_Transmit(&huart1, (const uint8_t*) mensagemUart, strlen(mensagemUart), 1000);
}

//
void HAL_ADC_ConvCpltCallback(ADC_HandleTypeDef* hadc)
{
  //HAL_ADC_Start_IT(&hadc1);
  FLAG_READY = 1;
}


//Funcao utilizada para controlar o pwm
void modulacao(float ref){
	TIM3->CCR2 = ref; //Atualiza o registrador do timer 3 que define o duty cycle.
	                  //o valor maximo do pwm configurado é 3599, d = ref/3599.
}

void malha_aberta(){
	uint16_t aux2 = 1080;
	if(HAL_GPIO_ReadPin (GPIOB, GPIO_PIN_11)){aux2 = 1800;}
	modulacao(aux2);
	//modulacao(pot_malha_aberta); //Referencia vira o potenciometro
}

void controle_malha_fechada(){


	/*

	 A declaracao das variaveis de controle foi feita no inicio
	 do codigo de forma a economizar tempo de processamento dentro
	 desta funcao

	 */

	//--------------------------------------------//
	// Malha de tensao                            //
	//--------------------------------------------//
	// Referencia de tensao                       //
	//-------------------------------------------//
	Voref = 15.0f;
	//Voref = pot_tensao;//A referencia vira o potenciometro


    //if(HAL_GPIO_ReadPin (GPIOB, GPIO_PIN_11)){Voref = 15.0f;}//aumenta a ref de tensao quando aperta-se o botao presente na placa


	//--------------------------------------------//
	// Conversao AD                               //
	//--------------------------------------------//
	// Leitura da tensao
	Vo = tensao;

	//--------------------------------------------//
	// Calculo do erro                            //
	//--------------------------------------------//
	evk0 = Voref - Vo;

	//debug_msg(evk0);

	//--------------------------------------------//
	// Atualizaçao da açao de controle      //
	//-------------------------------------------//
	uvk0 = uvk1 + (av1*evk0) + (av2*evk1);

	//--------------------------------------------//
	// Rotaçao das variaveis de tensao            //
	//--------------------------------------------//
	evk1 = evk0;
	uvk1 = uvk0;


	//--------------------------------------------//
	// Malha de corrente                          //
	//--------------------------------------------//
	// Referencia de corrente                    //
	//-------------------------------------------//
	iLref = uvk0;
	//iLref = 0.340f;
	//iLref = pot_corrente; // A referencia vira o potenciometro
	//if(HAL_GPIO_ReadPin (GPIOB, GPIO_PIN_11)){iLref = 0.680f;} //aumenta a referencia de corrente quando aperta-se o botao presente na placa

	//--------------------------------------------//
	// Conversao AD                                   //
	//--------------------------------------------//
	// Leitura da corrente
	iL = corrente;
	//--------------------------------------------//
	// Calculo do erro                                 //
	//--------------------------------------------//
	eik0 = iLref - iL;
    //debug_msg(eik0);

	//--------------------------------------------//
	// Atualizaçao da açao de controle      //
	//-------------------------------------------//
	uik0 = uik1 + (ai1*eik0) + (ai2*eik1);

	//Limitar a acao de controle de corrente por seguranca
	//if(uik0 > 2520.0f){uik0=2520.0f;}
	//if(uik0 < 10.0f){uik0=10.0f;}

	//--------------------------------------------//
	// Rotaçao das variaveis de corrent           //
	//--------------------------------------------//
	eik1 = eik0;
	uik1 = uik0;

	modulacao(uik0);
}

// AQUI EH A FUNCAO CHAMADA NA INTERRUPCAO DO TIMER3
//     ||||||||||
//     VVVVVVVVVV

void HAL_TIM_PeriodElapsedCallback(TIM_HandleTypeDef* htim)
{

	HAL_GPIO_TogglePin(GPIOB, GPIO_PIN_1);
	//HAL_GPIO_WritePin(GPIOB, GPIO_PIN_1, 1);


	//---------------------------//
	//Leitura dos ADCs e controle//
	//---------------------------//
    read_ADC(); // Funcao que executa a leitura dos adcs
    malha_aberta(); // Funcao que faz o conversor funcionar em malha aberta
    //controle_malha_fechada(); // Funcao que faz o conversor funcionar em malha fechada
    //---------------------------//


    //Funcoes que permites o debug atraves da porta serial//
    //debug_msg(pot);
    //print_MSG();
    //----------------------------------------------------//

    // Uma pista visual que o botao foi acionado e que que a referencia do controle foi alterada//
    if(HAL_GPIO_ReadPin (GPIOB, GPIO_PIN_11))
    {
        // Aciona o LED quando o botao da placa de instrumentacao é acionado
        HAL_GPIO_WritePin(GPIOB, GPIO_PIN_0, GPIO_PIN_SET);
    }
    else
    {
        // Desliga o LED quando o botao da instrumentacao é desacionado
        HAL_GPIO_WritePin(GPIOB, GPIO_PIN_0, GPIO_PIN_RESET);
    }
    //-----------------------------------------------------------------------//

    //HAL_GPIO_WritePin(GPIOB, GPIO_PIN_1, 0);
}
/* USER CODE END 4 */
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
