Pythorian/Conversor-Buck-Didatico/(commit log)

2024-04-08 Alterando o arquivo matlab para a última versão.
2024-04-12 Atualização0.1
    [GateDriver.kicad_pcb, GateDriver.kicad_sch]
2024-06-06 versão pré defesa
    [buckparameters.txt]
