Pythorian/Conversor-Buck-Didatico/(notices)

Notices in the files:
CubeIDE/main.c:
Copyright (c) 2023 STMicroelectronics.
All rights reserved.
This software is licensed under terms that can be found in the LICENSE file
